Mixior/Projekt_Przejsciowy/linki.txt

https://www.tme.eu/pl/details/os5oka5111y/diody-led-tht-5mm/optosupply/
https://www.tme.eu/pl/details/luw503f43/diody-led-tht-5mm/wenrun/luw503f43-a-02/
https://www.tme.eu/pl/details/ltw30eedyja/diody-led-tht-5mm/liteon/
https://www.tme.eu/pl/details/pm2e-1lwe/diody-led-mocy-biale-emiter/prolight-opto/
