Mixior/Projekt_Przejsciowy/Materialy/Projekt oświetlenia w pojeździe - Nawrot, Smyczyński/Wykaz elementów.pdf

C26, C28 | 100n | C0603 | 18 | https://www.tme.eu/pl/details/cl10b104ko8nnnc/kondensatory-mlcc-smd-0603/samsung/
C4, C6, C25, C41, C44 | 10uF/50V | 153CLV-0605 | 5 | https://www.tme.eu/pl/details/tyeh1h106f55mtr/kondensatory-elektrolityczne-smd-105c/te-connectivity/
C7, C8, C27 | 3,3n | C0603 | 3 | https://www.tme.eu/pl/details/cc0603krx7r9332/kondensatory-mlcc-smd-0603/yageo/cc0603krx7r9bb332/
C10,C15,C29 | 390p | C0603 | 3 | https://www.tme.eu/pl/details/c0603c391j5gac/kondensatory-mlcc-smd-0603/kemet/c0603c391j5gactu/
C12,C18,C31 | 33pF | C0603 | 3 | https://www.tme.eu/pl/details/06035a330jat2a/kondensatory-mlcc-smd-0603/avx/
C13 | 330p | C0603 | 1 | https://www.tme.eu/pl/details/06031c331k4t2a/kondensatory-mlcc-smd-0603/avx/
C16,C20-C22,C30,C33,C34 | 47uF/50V | 153CLV-0605 | 7 | https://www.tme.eu/pl/details/sc1h476m6l07kvr/kondensatory-elektrolityczne-smd-85c/samwha/
C19,C32 | 470p | C0603 | 1 | https://www.tme.eu/pl/details/06035c471k4t2a/kondensatory-mlcc-smd-0603/avx/
C36, C37, C38 | 10uF/50V X | C1206 | 3 | https://www.tme.eu/pl/details/c1206c105k3rac/kondensatory-mlcc-smd-1206/kemet/c1206c105k3ractu/
D1-D4,D6 | SS15 | DO-214AC | 5 | https://www.tme.eu/pl/details/ss15-dc/diody-schottky-smd/dc-components/ss15/
D7 | 1N4148 | D0603 | 1 | https://www.tme.eu/pl/details/1n4148-
D5 | BAV70.215 | SOT23 | 1 | https://www.tme.eu/pl/details/bav70.215/diody-uniwersalne-smd/nexperia/
IC1 | MCP16301HT-E/CH | SOT23-6 | 1 | https://www.tme.eu/pl/details/mcp16301ht-e_ch/regulatory-napiecia-uklady-dcdc/microchip-technology/
JP1 | 1x5 | 1X05 | 1 | https://www.tme.eu/pl/details/zl201-05g/listwy-i-gniazda-kolkowe/connfly/ds1021-1_5sf1-1/
L1-L3 | 47uH/440mA | 0403 | 3 | https://www.tme.eu/pl/details/dlg-0403-470/dlawiki-smd-mocy/ferrocore/
L4 | 47uH/720mA | 0504 | 1 | https://www.tme.eu/pl/details/dlg-0504-470/dlawiki-smd-mocy/ferrocore/
L5 | WLPN303015M150PB | 3 x 3 x 1.5mm | 1 | https://www.tme.eu/pl/details/wlpn303015m150pb/dlawiki-smd-mocy/walsin/
LED1-LED6, LED9-LED14, LED16- | FYLS-5050N | 5050, PLCC6 | 36 | https://www.tme.eu/pl/details/fyls- (https://www.tme.eu/pl/details/fyls-5050nrgbc/diody-led-smd-kolorowe/foryard/)
LED7, LED8, LED15, LED22, LED29, LED42 | X42180 | lambertian | 6

https://www.tme.eu/pl/details/pm2b-1lwe/diody-led-mocy-biale-emiter/prolight-opto/https://www.tme.eu/pl/details/pm2b-1lre/diody-led-mocy-kolorowe-emiter/prolight-opt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
PH1 | PGM5537 | VT800 | 1 | https://www.tme.eu/pl/details/pgm5537/fotorezystory/token/
Q1-Q3 | BSS314 | SOT23 | 3 | https://www.tme.eu/pl/details/bss314peh6327xtsa1/tranzystory-z-kanalem-p-smd/infineon-technologies/
R1-R4,R15,R16,R27-R34 | 4k7 | R0603 | 14 | https://www.tme.eu/pl/details/0603saj0472t5e/rezystory-smd-0603/royal-ohm/
R5,R7,R17 | 20k 0.1% | R0603 | 3 | https://www.tme.eu/pl/details/ar0603-20k-0.1%25/rezystory-precyzyjne-smd-0603/viking/ar03btcx2002/
R6,R8,R14,R18,R23 | 68k | R0603 | 5 | https://www.tme.eu/pl/details/crcw06038k06fktabc/rezystory-smd-0603/vishay/
R9,R10,R20,R24,R26, R35 | 10k | R0603 | 6 | https://www.tme.eu/pl/details/ar0603-10k-0.1%25/rezystory-precyzyjne-smd-0603/viking/ar03btcx1002/
R11,R13,R22 | 1M | R0603 | 3 | https://www.tme.eu/pl/details/ar0603-1m-0.1%25/rezystory-precyzyjne-smd-0603/viking/ar03btcx1004/
R12 | 100k | R0603 | 1 | https://www.tme.eu/pl/details/smd0603-100k/rezystory-smd-0603/royal-ohm/0603saj0104t5e/
Oznaczenie | Wartość | Obudowa | Szt. (dla jednej lampy) | link

C1-C3, C5, C23, C24, C35, C39, C40,C42, C43, C9, C11, C14, C17,

R19 | 0,56R 1% | R0603
R21 | 3k3 | R0603
R25 | 0R | R0603
R36 | 30k9 | R0603 | 1 | https://www.tme.eu/pl/details/rc0603f (https://www.tme.eu/pl/details/rc0603fr-0730k9l/rezystory-smd-0603/yageo/)
U1-U3 | ISL97671A | QFN20
U4 | AP8801 | SOP-08
U5 | STM32F042F | TSSOP20
U6 | PCA9545A | SO20W
U7 | SN65HVD230/1 | SO8
X1 | ARK R=5 | AK500/4
1 | https://www.tme.eu/pl/details/cs0603-0r56-1%25-hp/rezystory-smd-0603/viking/cs03ftfpr560/
1 | https://www.tme.eu/pl/details/smd0603-3k3/rezystory-smd-0603/royal-ohm/0603saj0332t5e/
1 | https://www.tme.eu/pl/details/smd0603-0r/rezystory-smd-0603/royal-ohm/0603saj0000t5e/
3 | http://pl.farnell.com/intersil/isl97671airz/led-driver-boost-6-channel-qfn/dp/2687076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
1 | http://pl.farnell.com/diodes-inc/ap8801sg-13/ic-led-driver-buck-0-5a-8sop/dp/1825358RL
1 | https://www.tme.eu/pl/details/stm32f042f6p6/mikrokontrolery-st/st-microelectronics/
1 | https://www.tme.eu/pl/details/pca9545ad/uklady-scalone-interfejs-i2c/nxp/pca9545ad112/
1 | https://www.tme.eu/pl/details/sn65hvd230d/uklady-scalone-interfejs-can/texas-instruments/
1 | https://www.tme.eu/pl/details/dg300-5.0-04p13/listwy-zaciskowe-do-druku/degson-electronics/dg300-50-04p-13-00ah/
