Mixior/Projekt_Przejsciowy/Materialy/eRower_Lights/PROJEKT/Raport.pdf

## Oświetlenie pojazdu elektrycznego przy użyciu magistrali CAN

Sergiusz Grześkowiak
Michał Kowalewski
Łukasz Jaskulski

2018

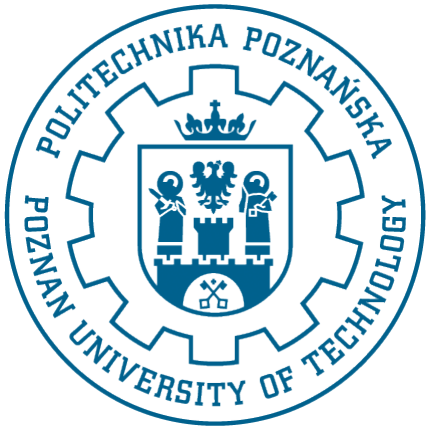
[picture p9: figure]

Stworzono przy użyciu LATEX

## Spis treści

1 Założenia i schematy | 2
2 Oprogramowanie | 8

1

## 1 Założenia i schematy

### 1.1 Kierunkowskazy

Projektując kierunkowskazy do pojazdu elektrycznego wzorowaliśmy się na dizajnie marki Audi. Gdzie w nowych modelach stosowane są dynamicznie płynące światła, jest to według nas najciekawsze rozwiązanie stawiające przed nami nowe wyzwania i możliwości. Problemem w sterowaniu tymi światłami jest to że każda pojedyncza dioda każdego kierunkowskazu musi posiadać osobne sterowanie barwą i natężeniem światła (w celu uzyskania płynnego efektu migania kierunkowskazu), ponad to światła te muszą spełniać rolę świateł do jazdy dziennej. Problemy te rozwiązaliśmy stosując paski ledowe oparte na diodach WS2811, które to diody zawierają wbudowany prosty układ scalony który umożliwia sterowanie wszystkimi diodami za pomocą jednego wyjścia mikrokontrolera.

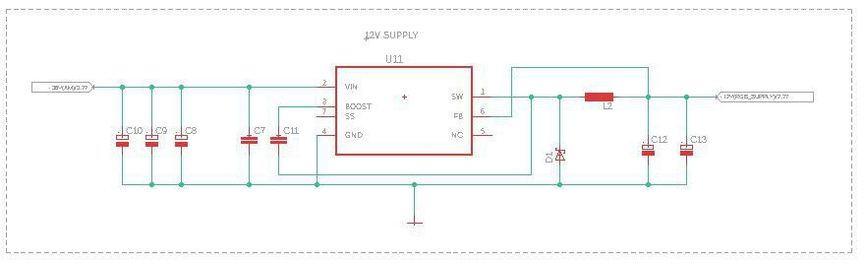
[picture p10: figure]

Rysunek 1: Zasilanie +12V DC programowalnych diod rgb

### 1.2 Światła mijania, drogowe, stopu

Do sterowania diodami dużej mocy zastosowaliśmy układ AP8801 500mA LED STEP-DOWN CONVERTER oprócz wspólnego sterowania dla każdego typu świateł każdy zestaw świateł zawierać będzie zestaw 2 pasków led (pojedynczy pasek na lewą i prawą stronę) po 9 diod, na każdy jeden pasek przypadać będzie jeden układ AP8801 (ze względu na jego wewnętrzne ograniczenia). W sumie samych układów step down będzie 6 każdy będzie odpowiedzialny za jedno światło(mijania lewe, mijania prawe, drogowe lewe, drogowe prawe, stop/mijania tylne lewy, stop/mijania tylne prawy), umożliwi to proste sterowanie i wykrywanie awarii oświetlenia.

2

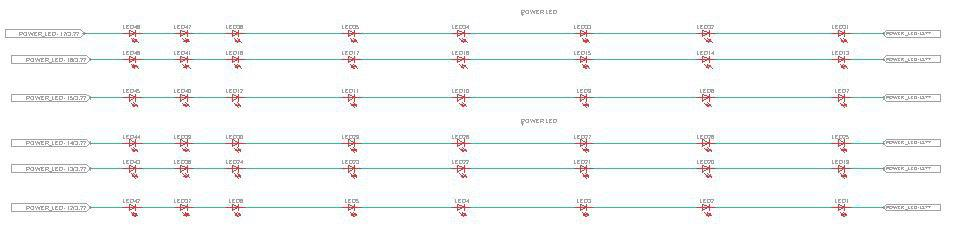
[picture p11: figure]

Rysunek 2: Paski 9 diod świateł mijania/drogowych/stop

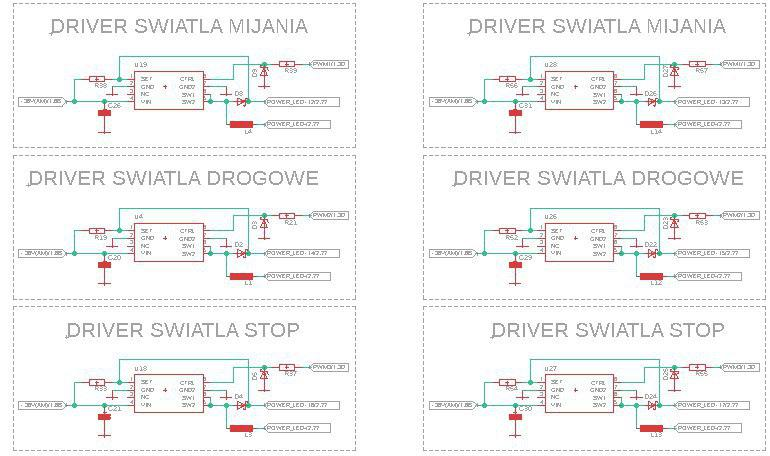
[picture p12: figure]

Rysunek 3: Podział Power LED draiverów na poszczególne segmenty

Awarie świateł wykrywamy aktywnie przy uruchomieniu pojazdu mierzony jest wówczas prąd pobierany na cały układ i porównywany z wartością znamionową. Ze względu na użycie jednego układu AP8801 na jedno światło w momencie przepalenia jednej diody prąd pobierany spadnie o jedną szóstą.

3

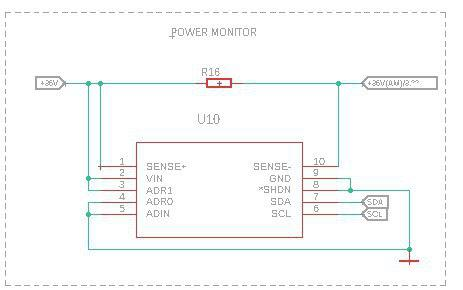
[picture p13: figure]

Rysunek 4: Wysoko napięciowy monitor prądu i napięcia z magiistralą I2C

### 1.3 Zasilanie

Zgodnie z założeniami cały projekt działa na zasilaniu +36 V DC. Ze względu na wykorzystanie mikrokontrolera STM 32, oraz programowalnych diod led, stosujemy 2 układy obniżania napięcia z 36V na 3,3V (do mikrokontrolera) oraz 12V (do programowalnych diod).

4

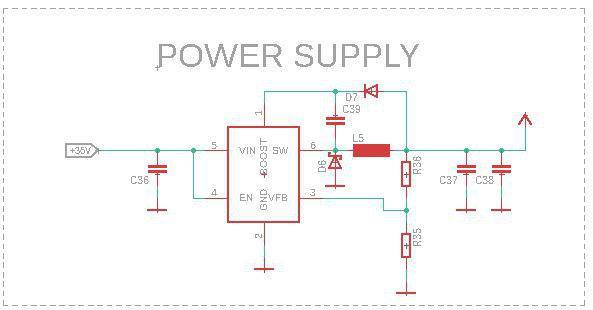
[picture p14: figure]

Rysunek 5: Stepdown na 3V3 dla mikrokontrolera

### 1.4 BRD

Schemat brd został zaprojektowany zachowując odpowiednie szerokości ścieżek proporcjonalnie do płynących w nich sygnałów. Kondensatory odsprzęgające znajdują się możliwie najbliżej układów scalonych. Uniknięto zamknięcia pętli masy.

Poprzez duże nagromadzenie elementów na jednej płytce. Możliwie redukujemy koszty wykonania gotowych modułów . Ograniczamy zbędne miejsce, które pojawiłoby się w przypadku rozdzielenia modułów. Ponadto zwężamy koszt o zamówienie tylko jednego projektu, co przekłada się na lepsze warunki podczas masowej produkcji.

5

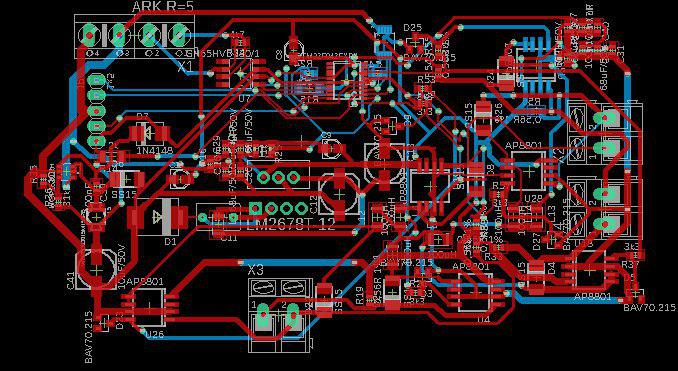
[picture p15: figure]

Rysunek 6: Kolorem czerwonym zaznaczone są ścieżki warstwy górnej, natomiast niebieskim warstwy dolnej

### 1.5 Mikrokontroler

Zastosowanym mikrokontrolerem jest STM32F042F6P6. Zgodnie z założeniami projektu wybraliśmy mikrokontroler z rodziny STM32. Jest to najtańszy mikrokontroler z rodziny STM32 obsługując magristralę CAN, a jednocześnie w zupełności zaspokajający potrzeby projektu.

6

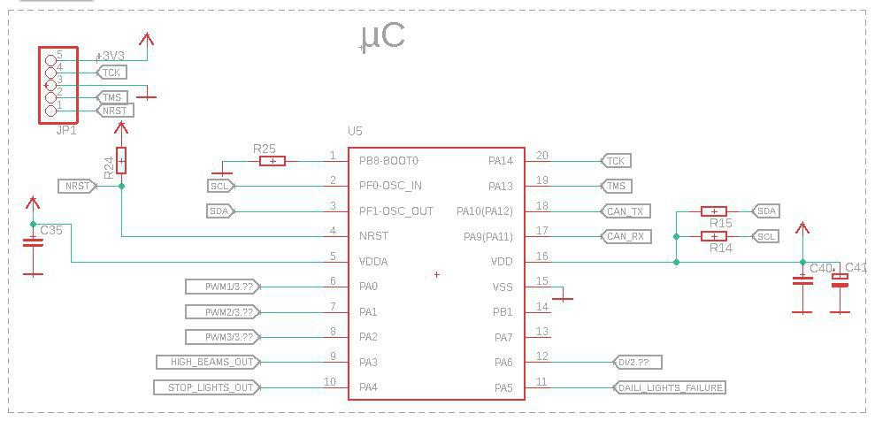
[picture p16: figure]

Rysunek 7: Schemat STM32F042F6P6

7

## 2 Oprogramowanie

### 2.1 Konfiguracja wyprowadzeń mikrokontrolera

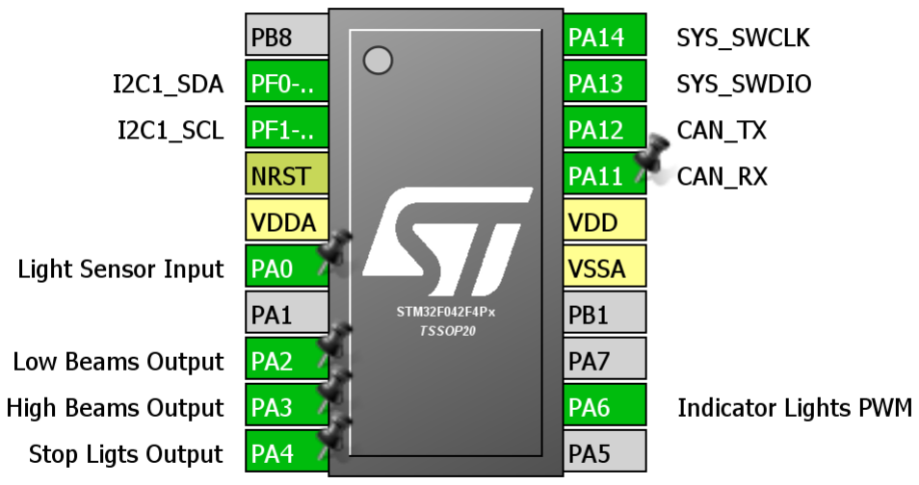
[picture p17: figure]

Rysunek 8: Wyprowadzenia mikrokontrolera

Zastosowanie innych rozwiązań niż poprzedni twórcy projektu [1] pozwoliło na wykorzystanie mniejszej ilości wyprowadzeń mikrokontrolera. W połączeniu z konfiguracją Debug Serial Wire na pinach PA14 oraz PA13 mamy możliwość przeprogramowania mikrokontrolera w przyszłości, co może pozwolić na dodanie dodatkowych funkcji i wykorzystanie niezagospodarowanych wyprowadzeń.

8

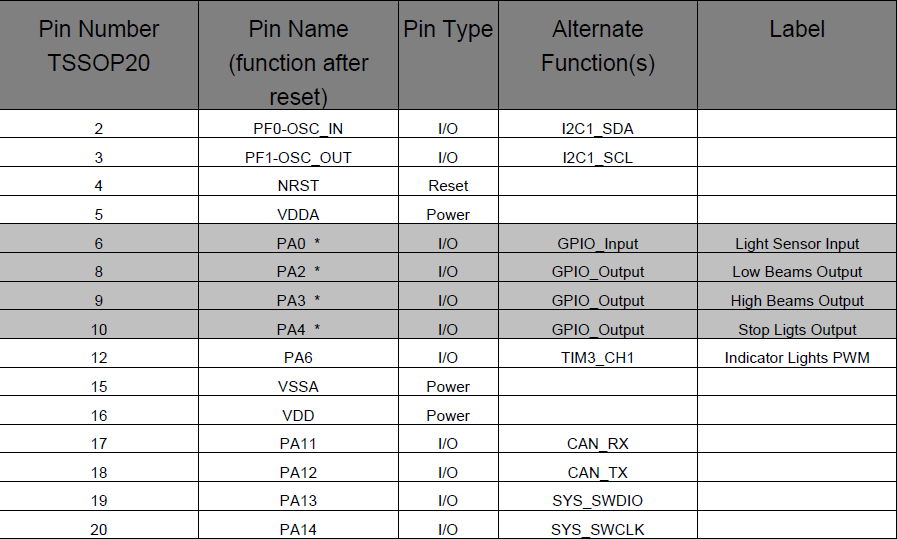
[picture p18: figure]

Rysunek 9: Raport konfiguracja wyprowadzeń

### 2.1.1 I2C

Wyprowadzenia PF0-OSC_IN oraz PF1-OSC_OUT zostały wykorzystane do skonfigurowania magistrali I

2C. Mikrokontroler komunikuje się tą magistralą z monitorem prądu LTC4151, który służy do wykrywania awarii układu [3].

9

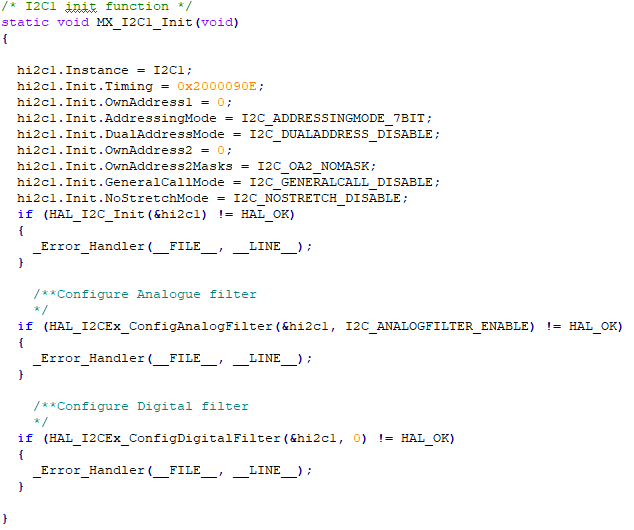
[picture p19: figure]

Rysunek 10: Inicjalizacja komunikacji po magistrali I

2C rzy użyciu HAL

Konfiguracja I

2C uniemożliwiła wykorzystanie zewnętrznego oscylatora kwarcowego [2], przez co do taktowania procesora wykorzystujemy wbudowany oscylator 48MHz, który dla naszych zastosowań jest bardziej niż wystarczający.

### 2.1.2 Piny wejścia/wyjścia

Do sterowania oświetlenie wykorzystane są wyprowadzenia PA2, PA3, PA4 oraz PA6. Pin PA0 służy do monitorowania stanu czujnika światła.

10

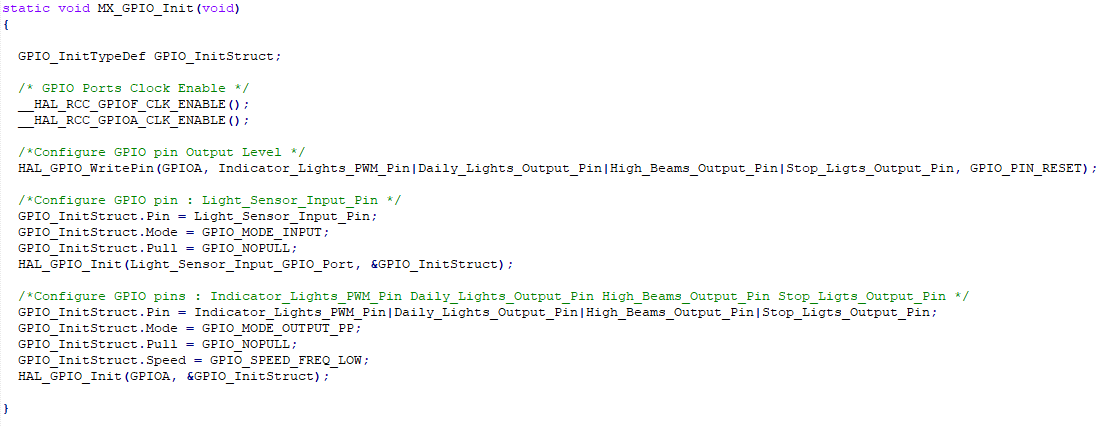
[picture p20: figure]

Rysunek 11: Konfiguracja pinów wejścia/wyjścia

### 2.1.3 CAN

Zgodnie z wymaganiami specyfikacji [2], do komunikacji po magistrali CAN wykorzystane zostały wyprowadzenia PA11 oraz PA12. Szczegóły konfiguracji zostaną opisane w dalszej części raportu.

11

### 2.2 Timery

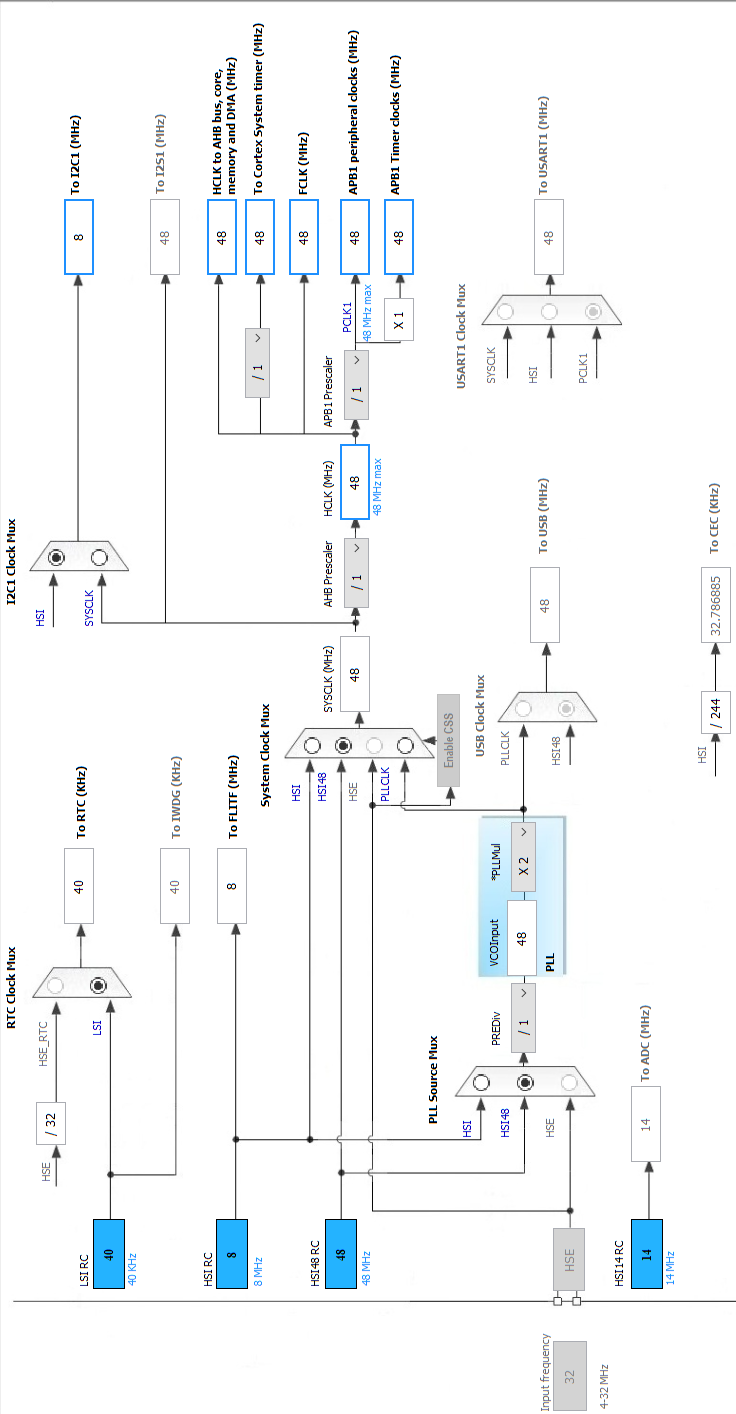
[picture p21: figure]

Rysunek 12: Konfiguracja zegarów mikroprocesora w IDE STM32CubeMX

12

W projekcie wykorzystywane są trzy wewnętrzne oscylatory:

- HSI RC, służy do taktowania magistrali I

2C z częśtotliwością 8MHz

- HSI48 RC, taktuje procesor z częstotliwością 48MHz
- LSI RC wykorzystujemy do konfiguracji zegara czasu rzeczywistego.

Ponadto w projektcie używane są dwa liczniki: Timer3 oraz RTC. Timer3 służy do generowania sygnału PWM sterującego programowalną listwe LED. Wszystkie zegary, oprócz zegara RTC zostały skonfigurowane z pomocą powłoki HAL.

13

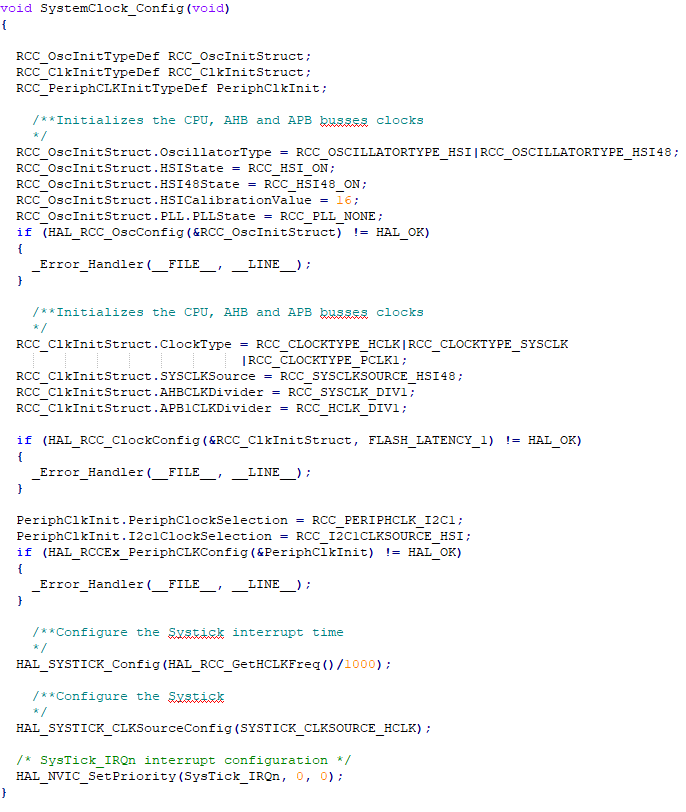
[picture p22: figure]

Rysunek 13: Funkcja konfigurująca główne zegary procesora

### 2.2.1 Real Time Clock

Do obsługi kierunkowskazów oraz świateł awaryjnych konieczne było skonfigurowanie zegara czasu rzeczywistego (RTC). Wykorzystuje on wewnętrzny

14 oscylator niskoczęstotliowściowy (LSI RC) o częstotliwości 40kHz. Odczytywanie czasu rzeczywistego od uruchomienia modułu zostało zaprogramowane w funkcji void RTC (*p_buf). Przez wywołanie odpowiedniej funkcji jesteśmy wstanie odczytać czas od uruchomienia w postaci godzin, minut, sekund i milisekund.

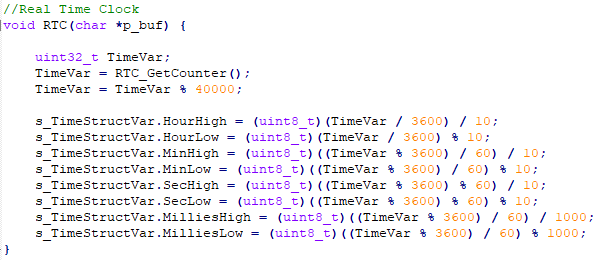
[picture p23: figure]

Rysunek 14: Funkcja konfigurująca zegar czasu rzeczywistego

W momencie włączenia kierunkowskazu lub świateł awaryjnych generowany jest sygnał PWM włączający odpowiednie diody oraz zapisywana jest do zmiennej wartość z zegara czasu rzeczywistego. Przy następnym cyklu procesora zapisana wartość porównywana jest z nową wartością RTC i następuje sprawdzenie, czy różnica czasu jest większa lub równa wartości stałej Indicator_interval.

Stała Indicator_Interval została zadekalrowana jako const static unsigned int, w celu obptymalizacji zużycia pamięci mikroprocesora, a jego wartość ustaliliśmy jako 500.

15

Oznacza to, że po upływie 500 milisekund następuje sekwencja włączania lub wyłączania odpowiednich diod. Daje nam to pulsacje o okresie 1 sekundy.

### 2.3 CAN

Podstawowym zadaniem przy pisaniu opragramowania było konfiguracja komunikacje po magistrali CAN. Pin PA12 służy do wysyłania informacji po magistrali, natomiast PA13 do odbierania.

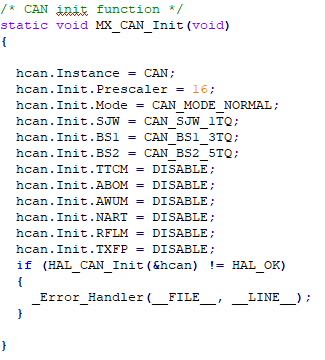
[picture p24: figure]

Rysunek 15: Inicjalizacja CAN

Zgodnie z dokumentacją [2], skonfigurowane zostały trzy skrzynki odbiorcze, w których przechowywane są wiadomości, aż do czasu wykonania odpowiednich funkcji.

16

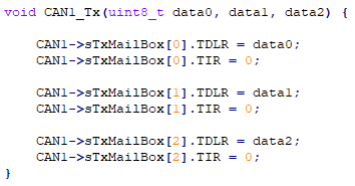
[picture p25: figure]

Filtr magistrali został skonfigurowany na priorytet identyfikatora wiadomości. Oznacza to, że informacja z niższym numerem ID zostanie obsłużona jako pierwsza.

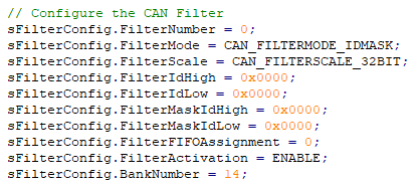
[picture p26: figure]

W projekcie założyliśmy siedem modułów, od których może zostać odebrany sygnał: Przełącznik świateł długich, świateł drogowych, świateł awaryjnych, pedał stopu oraz obu kierunkowskazów.

17

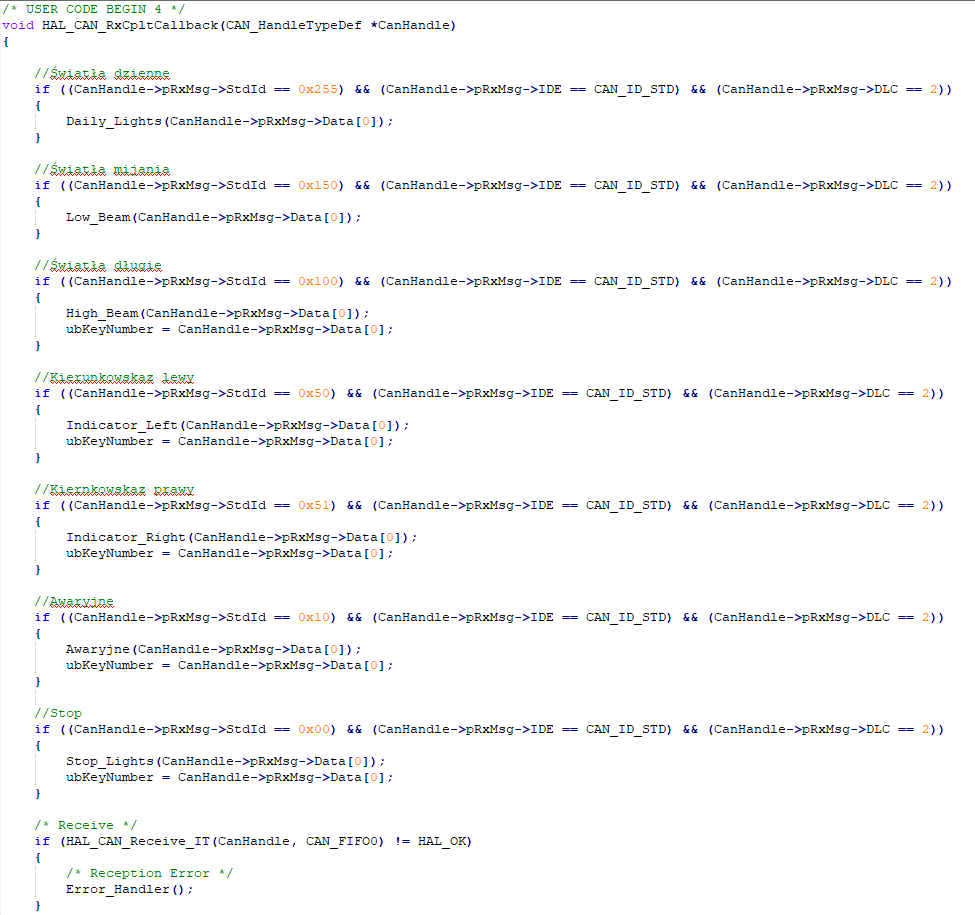
[picture p27: figure]

Rysunek 16: Obsługa odbioru wiadomości od poszczególnych modułów

Przyjęliśmy, że najniższe ID (0x00) będzie posiadał komunikat o światłach stopu. Oznacza to, że informacja o wciśnięciu lub zwolnieniu hamulca będzie zawsze obsługiwana jako pierwsza. Następnie w kolejności: informacja o światłach arawyjnych, kierunkowskazach, światłach długich, światłach mijania oraz światłach dziennych.

Jednakże z powodu, że instrukcje procesora są proste i jedynie programowalna listwa RGB wymaga od nas modulacji bardziej skomplikowanego sygnału PWM, nie spodziewamy się sytuacji przepełnienia skrzynki odbiorczej. Nawet sytuacja w której otrzymalibyśmy trzy informacje na raz nie powinna

18 wywołać widocznego opóźnienia reakcji.

### 2.4 Programowalna listwa LED

Wykorzystanie diod programowalnych typu WS2811 pozwoliło wyeliminować LED drivery zastosowane przez poprzednią grupę, oraz sterowanie czterena kierunkowskazami oraz światłami dziennymi jednym sygnałem PWM.

Sygnał dla WS2811 nie jest sygnałem typowym. Wartość niska kodowana jest przez ustawienie stanu wysokiego przez 220ns do 380ns [4], a następnie stanu niskiego trwającego od 580ns do 1,6us. Natomiast stan wysoki kodujemy ustawiając stan wysoki na 580ns do 1,6us, a następnie stan niski od 220ns do 420ns. Ustawienie stanu niskiego przez minimum 280us stanu niskiego oznacza reset.

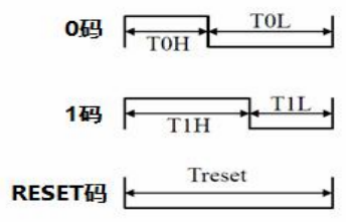
[picture p28: figure]

Rysunek 17: Kodowanie bitu [4]

Pojedyncze słowo składa się 24 bitów. W słowie przypada 8 bitów na pojedynczą diodę: Czerwoną, Niebieską i zieloną. 8 bitów pozwala nam uzyskać 255 stopni regulacji intensywności świecenia dla każdej z 3 składowych diod.

19

Rysunek 18: Kompozycja jednego słowa [4]

Sterowniki diod połączone są ze sobą kaskadowo. Każdy sterownik interpretuje najmłodsze słowo sygnału, odcine je i przekazuje resztę sygnału dalej, tak jak pokazano to na rysunkach.

Rysunek 19: Kaskadowe połączenie sterowników [4]

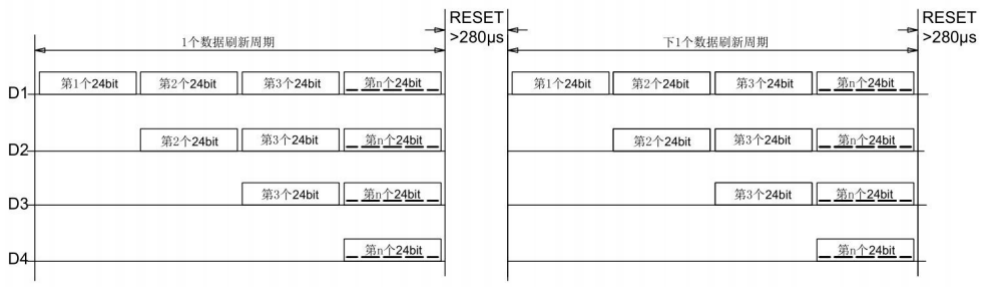
[picture p29: figure]

Rysunek 20: Zasada przepływu sygnałów [4]

Oznacza to, że w pojedynczej sekwencji musimy nadać 180 bajtów. Licząc, że na nadanie jednego bitu potrzeba około 1us, to pojedyncza sekwencja będzie trwać 1440us + 280us bitu stopu. Rozważmy przypadek w którym obsługujemy kierunkowskaz i rozpoczynamy wysyłanie 60 słów do naszego paska ledowego. Jeśli w tym samym momencie użytkownik wyłączy kierunkowskaz, to dla ludzkiego oka reakcja będzie natychmiasotwa, mimo

20 konieczności nadania wszystkich słów.

Tak jak było wspomniane, sygnał modulowany dla listwy ledowej jest dość nietypowy, przez co obsługa jje mogłaby przysporzyć wielu problemów. Na szczęście w powłoce HAL dostępna jest biblioteka znacznie ułatwiająca konfiguracje.

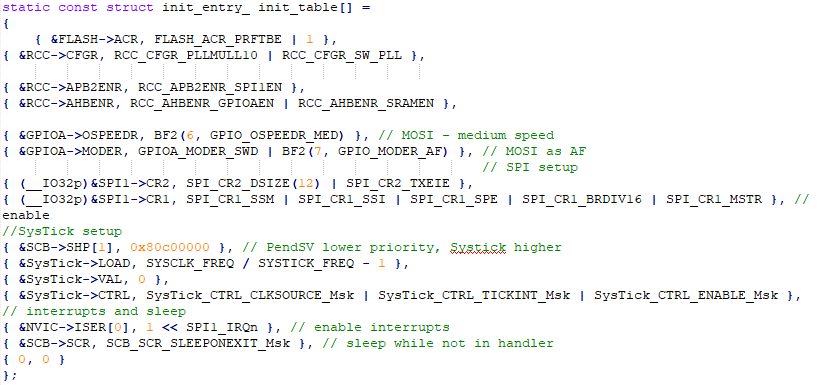
[picture p30: figure]

Dzięki temu byliśmy wstanie zaprogramować płynnięcie kierunkowskazu, wzrosując się na efekcie uzyskanym w samochodach marki Audi.

21

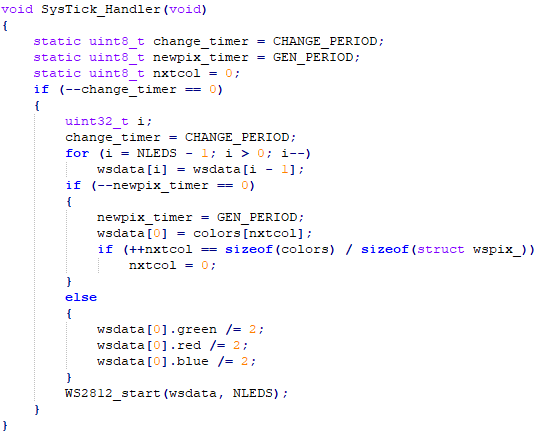
[picture p31: figure]

### 2.5 Czujnik światła

Po uruchomieniu pojazdu, w zależności od sygnału z czujnika natężenia światła następuje włączenie świateł dziennych lub mijania. Oświetlenie jest przełączane w zależności od obecnych odczytów czujnika do czasu aż operator pojazdu nie wykona następujących operacji: Ręczne wyłączenie świateł dziennych lub mijania, ręczne włączenie świateł długich, dziennych lub mijania. Po wystąpieniu takiego zdarzenia kontroler nie będzie reagował na sygnały z czujnika natężenia światła, aż do następnego uruchomienia pojazdu.

22

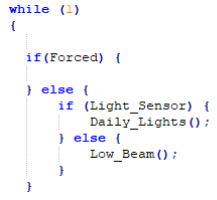
[picture p32: figure]

### 2.6 Wykrywanie awarii

Wykrywanie awarii polega na włączeniu na dwie sekundy wszystkich świateł i pomiar łącznego poboru prądu przez monitor prądu LTC4151. Wartość ta zostaje wysłana magistralą I

2C do mikrokontrolera, gdzie zostaje porównana ze znamionowym poborem prądu. Jeśli wartości różnią się od siebie o 20%, mikrokontroler wysyła po magistrali CAN (w domyśle do głównego komputera pojazdu) informacje o błędzie.

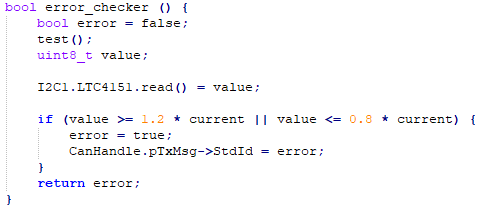
[picture p33: figure]

23

## Bibliografia

[1] Sławomir Smyczyński Arkadiusz Nawrot. Projekt oświetlenia w pojeździe. 2018.
[2] STM32. STM32F042x4 STM32F042x6 Data Sheet.
[3] Linear Technology. LTC4151 datasheet.
[4] Worldsemi. WS2811 - Signal line 256 Gray level 3 channel Constant current LED driver IC datasheet.

24
