Mixior/Projekt_Przejsciowy/Materialy/eRower_Lights/components.odt

OF-LM002-3B580 (http://www.tme.eu/pl/details/of-lm002-3b580/diody-led-mocy-biale-cob/optoflash/)
