Mixior/Projekt_Przejsciowy/Materialy/Projekt oświetlenia w pojeździe - Nawrot, Smyczyński/schemat_ideowy.pdf

# św. dzienne/kierunkowskaz

kolumna 6 | kolumna 5 | kolumna 4 | kolumna 3 | kolumna 2 | kolumna 1

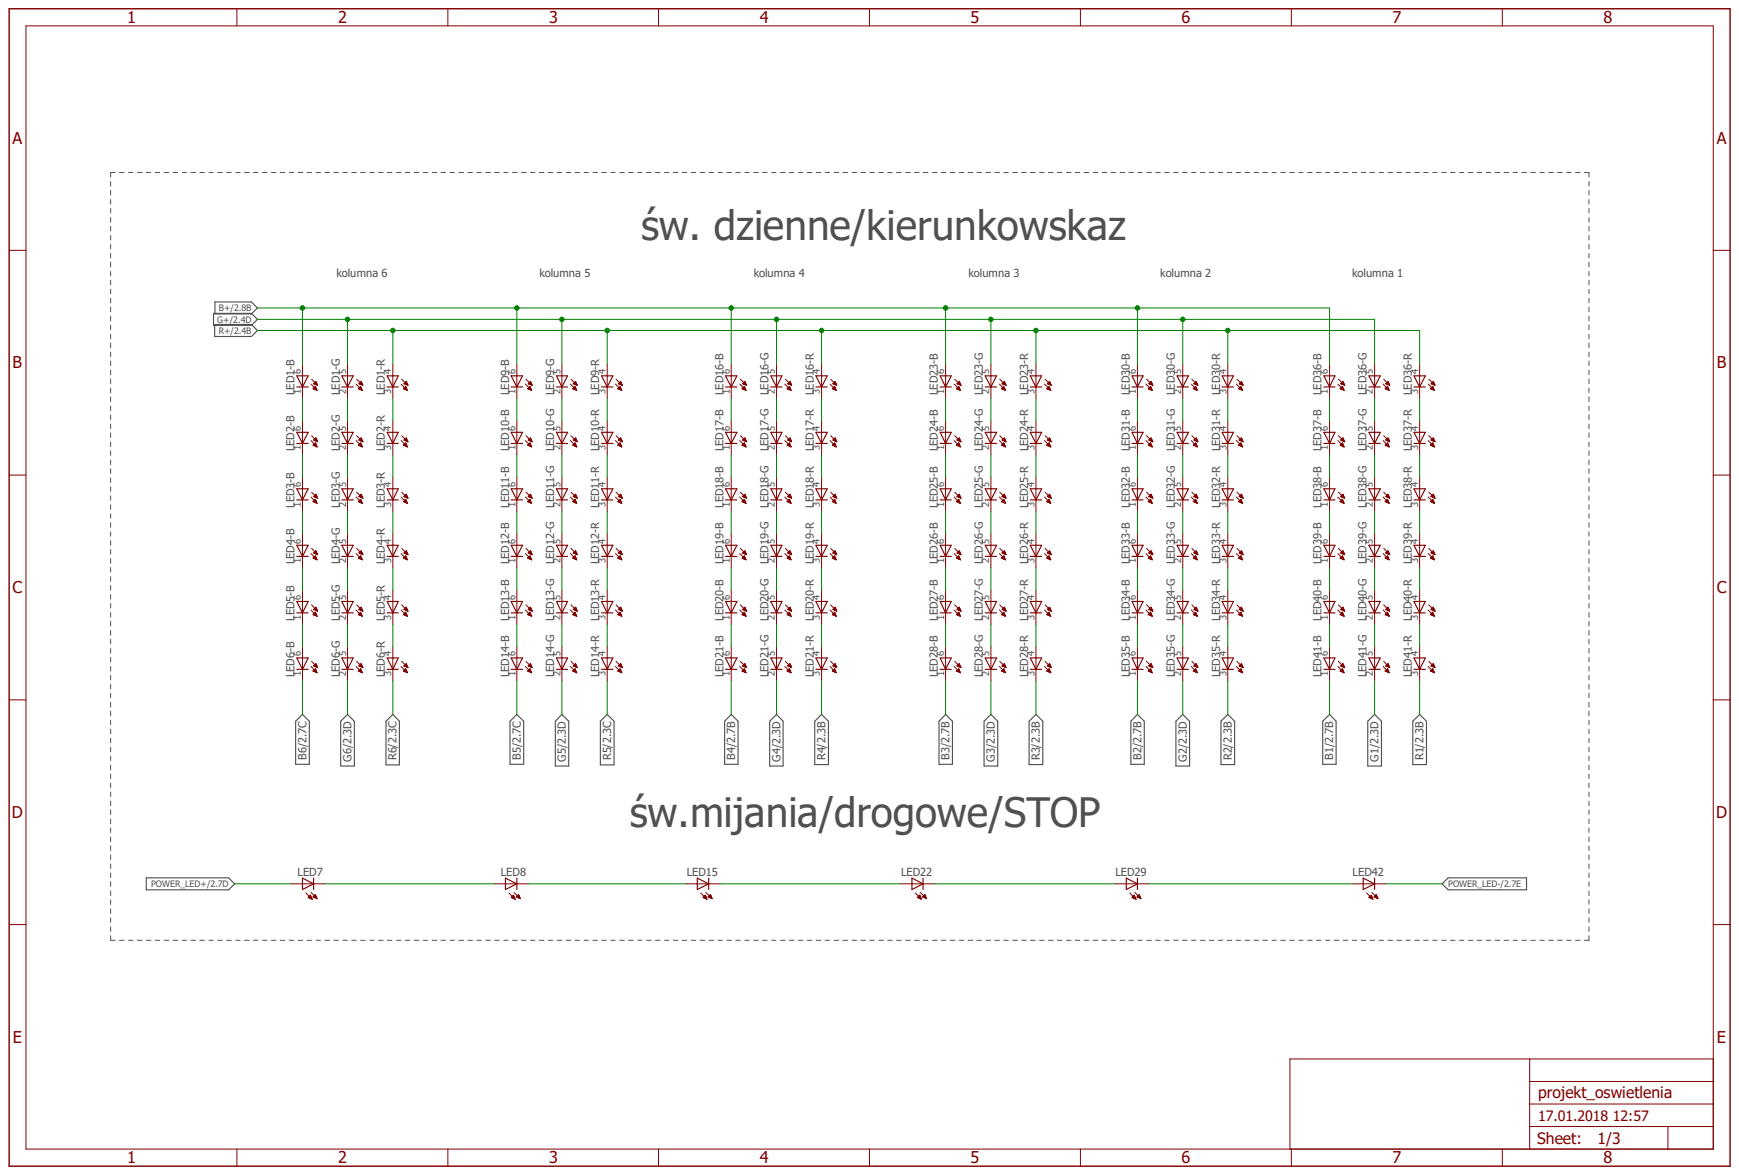
[picture p34: page 1]
św.mijania/drogowe/STOP LED⁹⁻B 1 6; LED⁹⁻G 2 5; LED⁹⁻R 3 4 LED¹⁰⁻B 1 6; LED¹⁰⁻G 2 5; LED¹⁰⁻R 3 4 LED¹¹⁻B 1 6; LED¹¹⁻G 2 5; LED¹¹⁻R 3 4 LED¹²⁻B 1 6; LED¹²⁻G 2 5; LED¹²⁻R 3 4 LED¹³⁻B 1 6; LED¹³⁻G 2 5; LED¹³⁻R 3 4 LED¹⁴⁻B 1 6; LED¹⁴⁻G 2 5; LED¹⁴⁻R 3 4 LED¹⁻B 1 6; LED¹⁻G 2 5; LED¹⁻R 3 4 LED²⁻B 1 6; LED²⁻G 2 5; LED²⁻R 3 4 LED³⁻B 1 6; LED³⁻G 2 5; LED³⁻R 3 4 LED⁴⁻B 1 6; LED⁴⁻G 2 5; LED⁴⁻R 3 4 LED⁵⁻B 1 6; LED⁵⁻G 2 5; LED⁵⁻R 3 4 LED⁶⁻B 1 6; LED⁶⁻G 2 5; LED⁶⁻R 3 4; LED²³⁻B 1 6; LED²³⁻G 2 5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

# LED DRIVER 3

# LED DRIVER 1 Q²

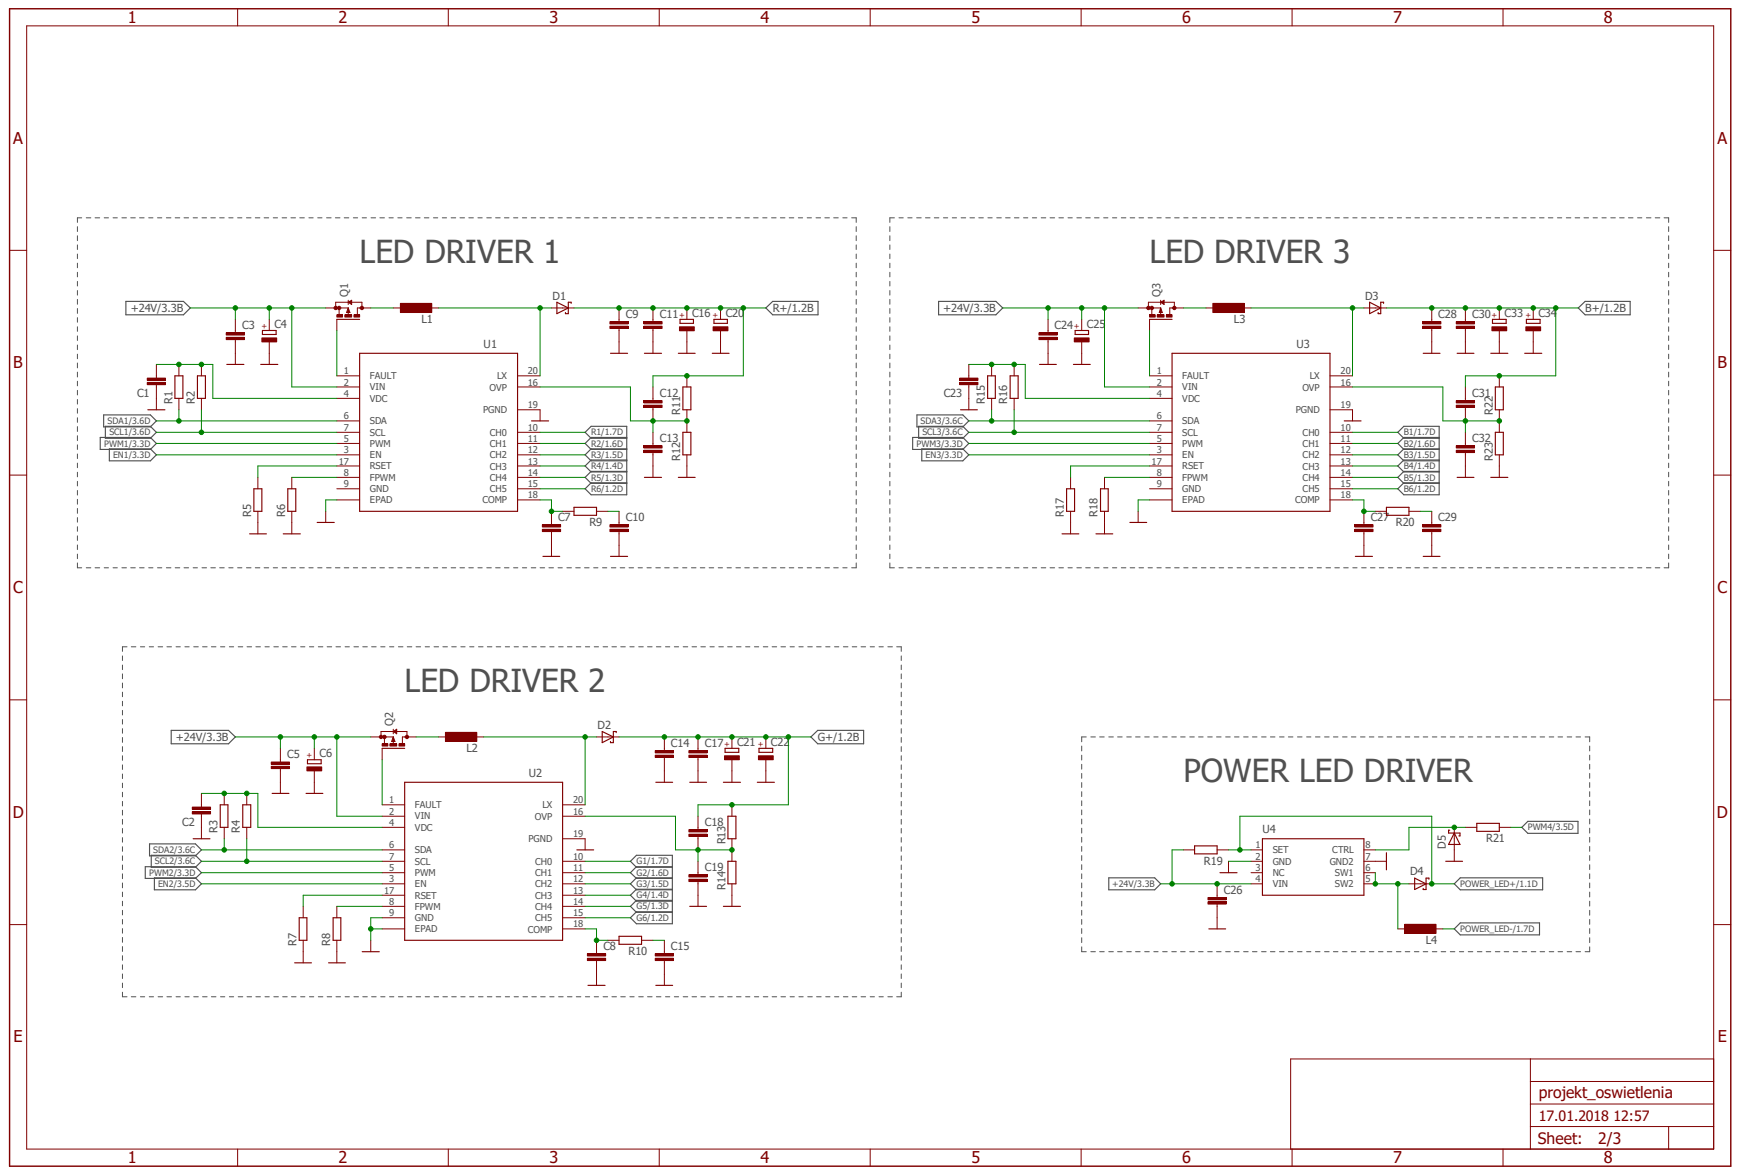
[picture p35: page 2]

# ZASILANIE

C39

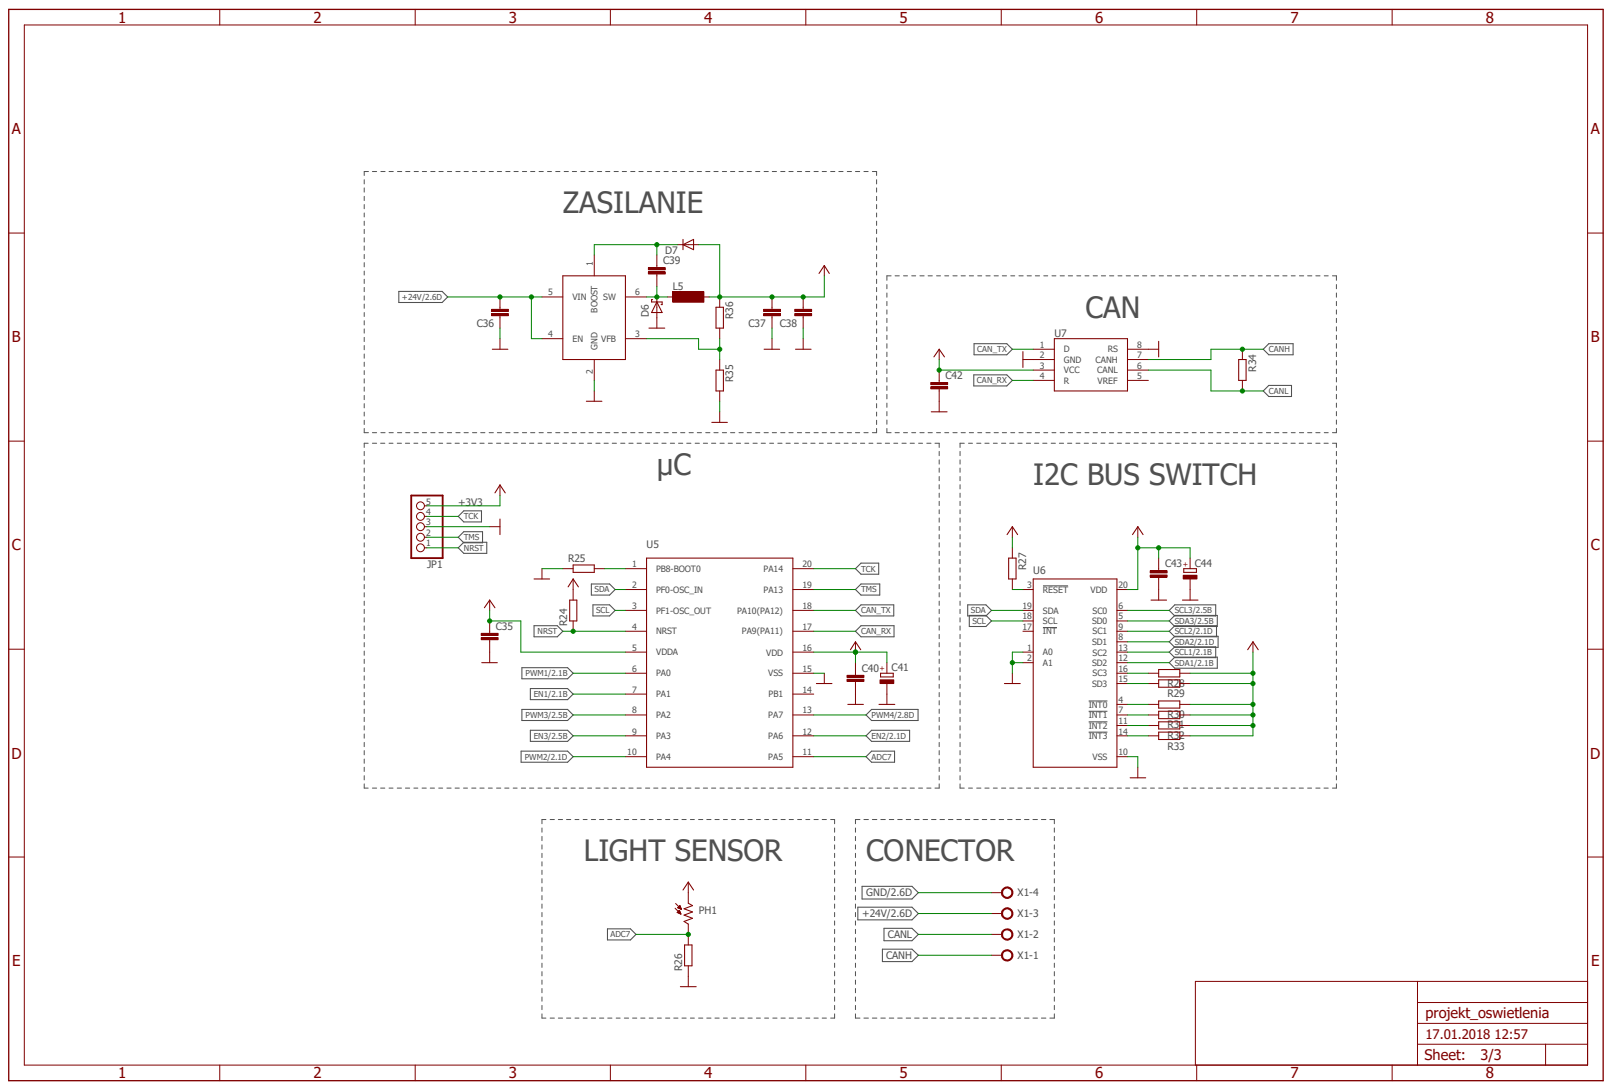
[picture p36: page 3]

4 CAN_RX I2C BUS SWITCH

NRST | VDDA 5 | CAN_RX
