Mixior/Projekt_Przejsciowy/Materialy/eRower_Lights/PROJEKT/projekt_oswietlenia1.pdf

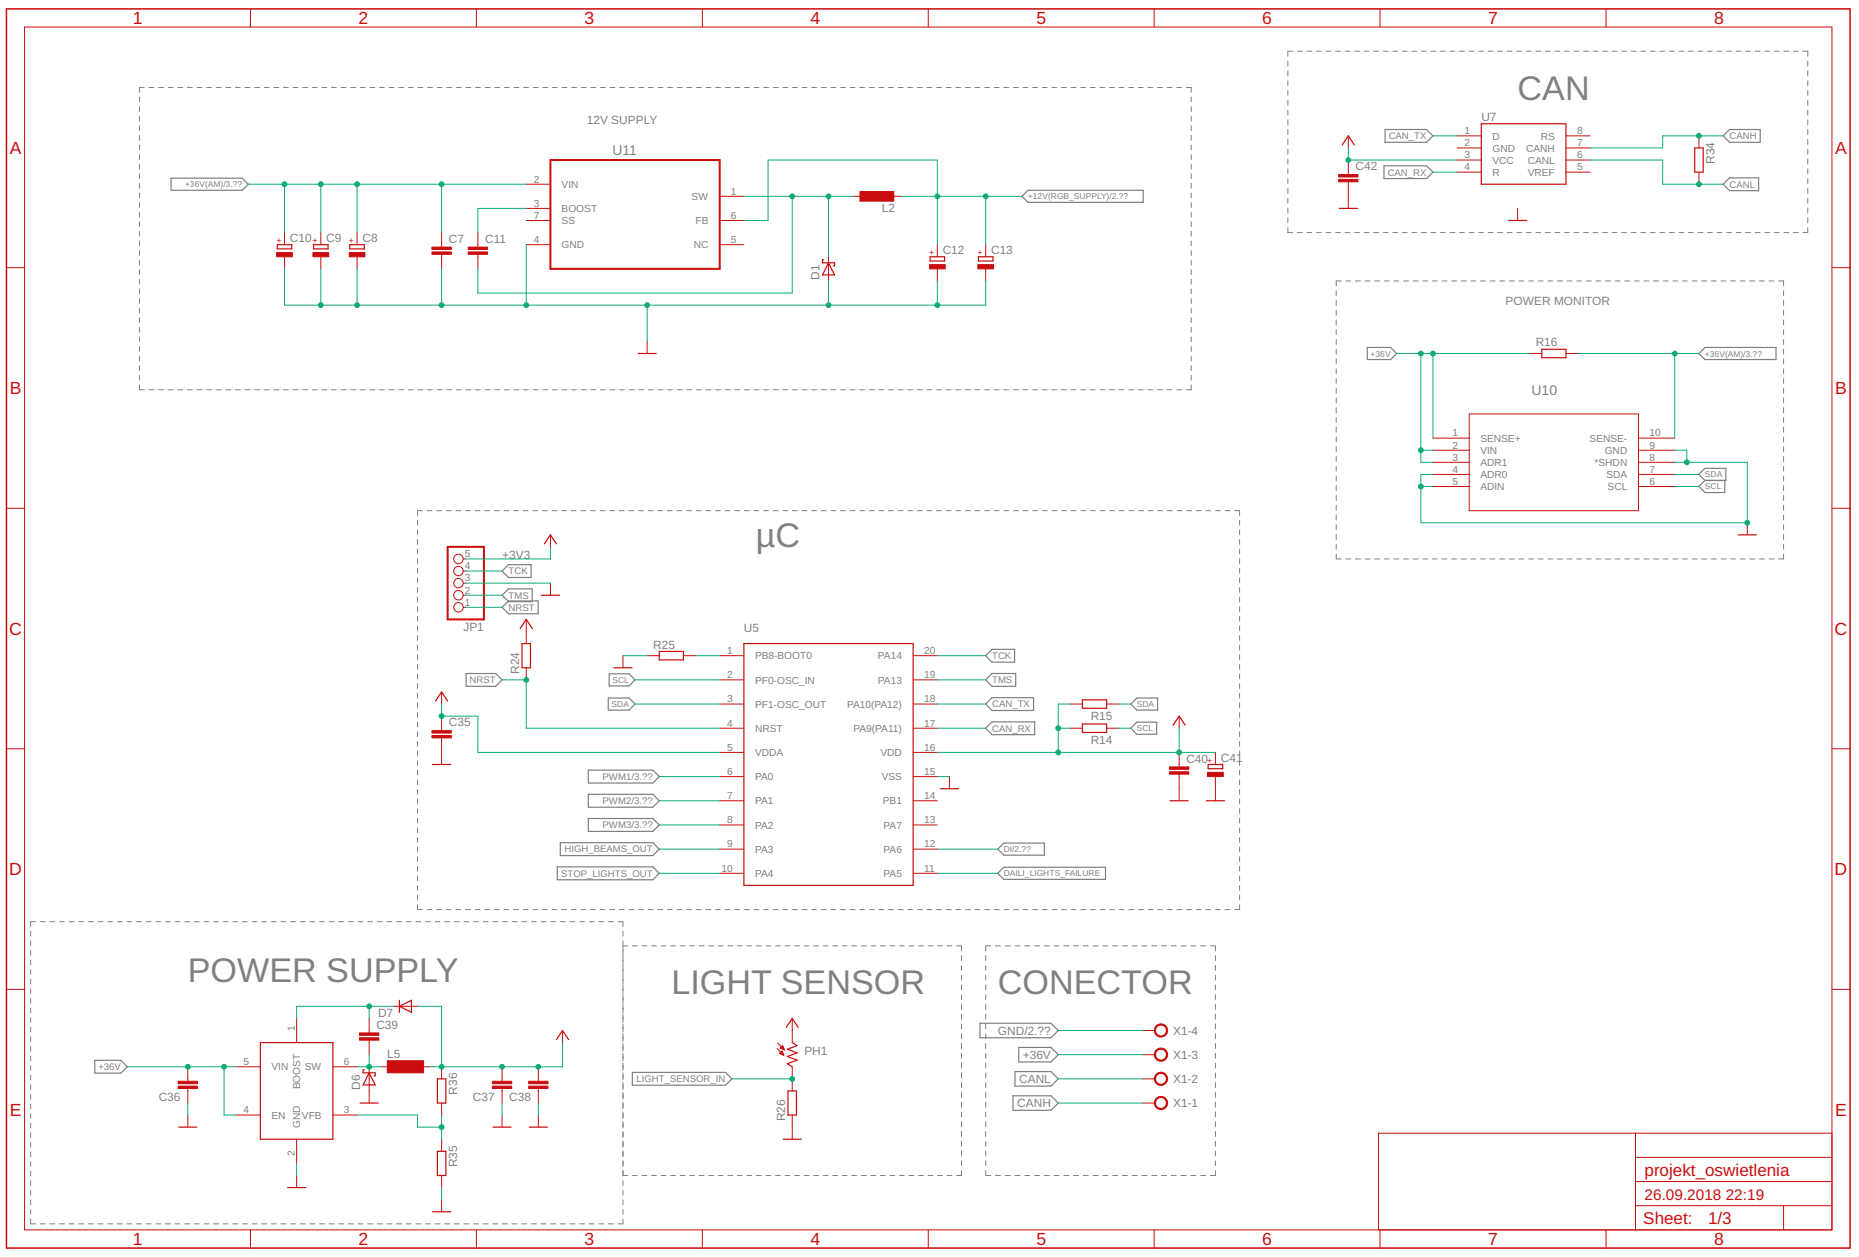
[picture p37: page 1]
