Mixior/Projekt_Przejsciowy/Materialy/eRower_Lights/PROJEKT/projekt_oswietlenia2.pdf

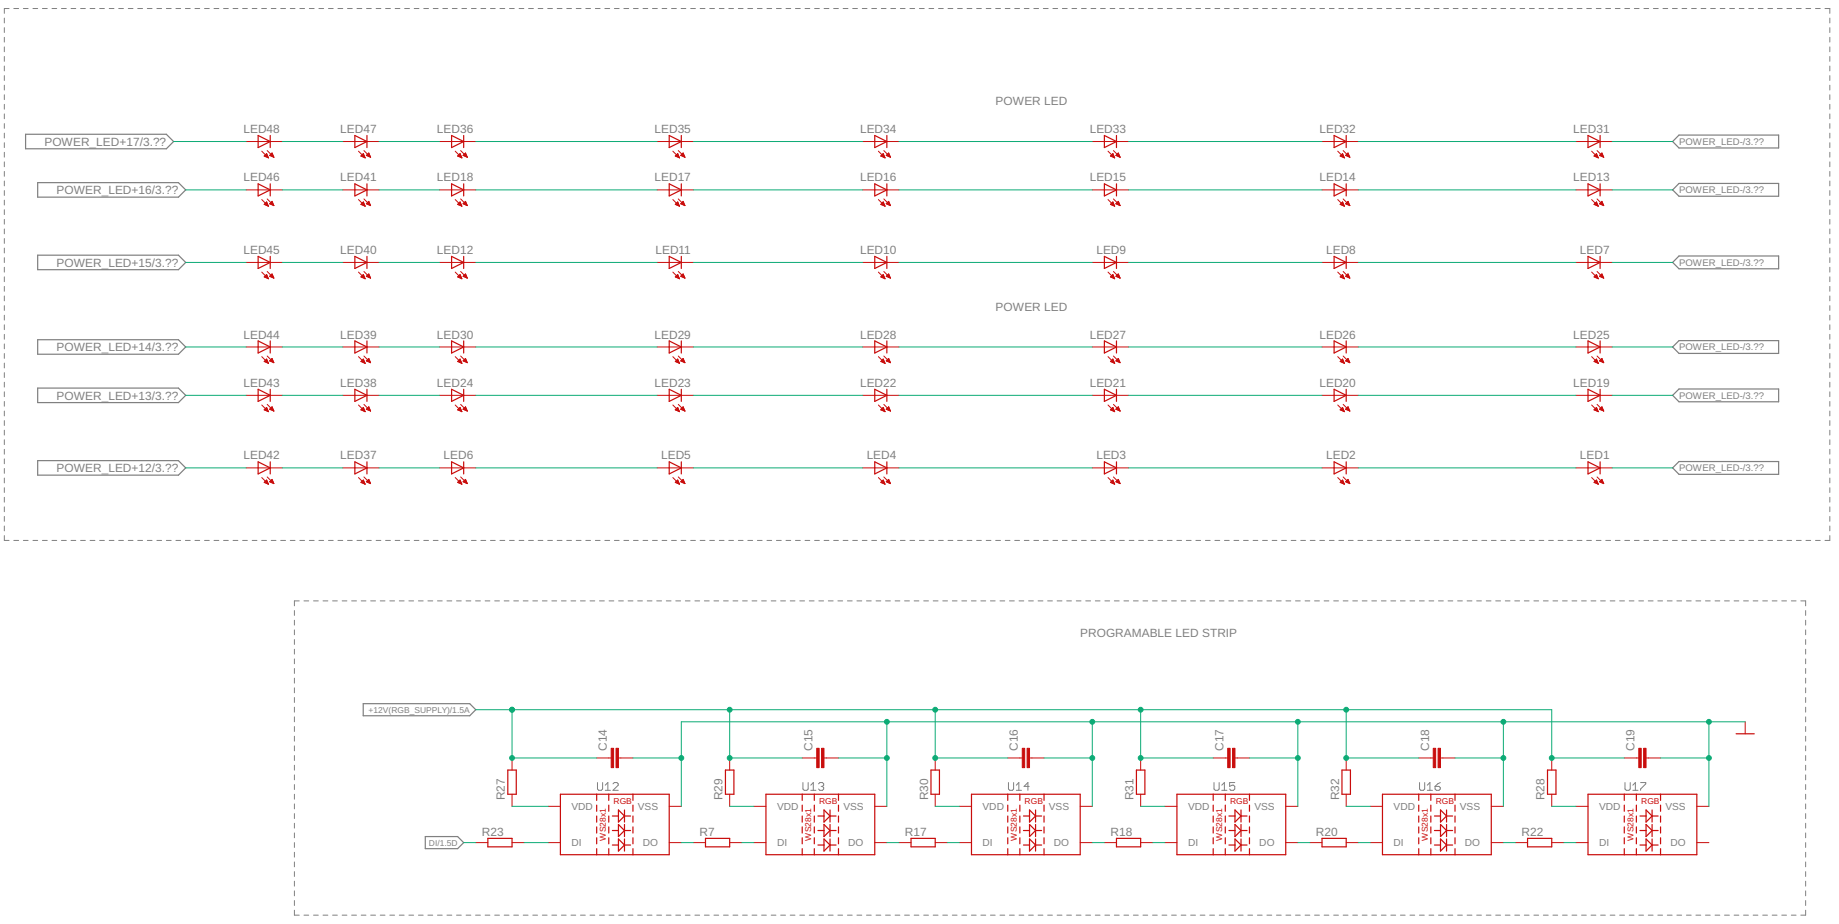
[picture p38: page 1]
