Mixior/Projekt_Przejsciowy/Materialy/eRower_Lights/PROJEKT/projekt_oswietlenia3.pdf

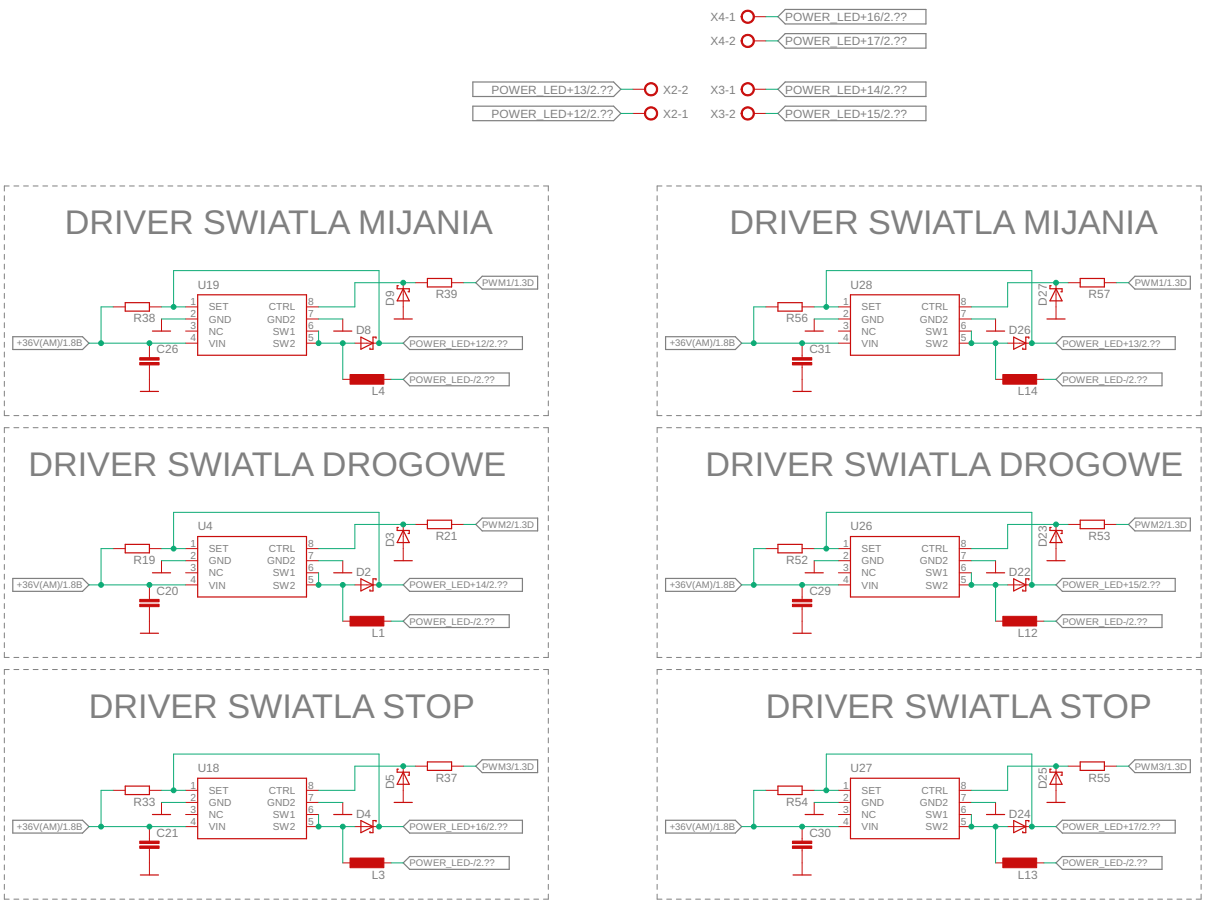
[picture p39: page 1]
