Mixior/Projekt_Przejsciowy/Materialy/Projekt oświetlenia w pojeździe - Nawrot, Smyczyński/Eagle/projekt_oswietlenia.brd

## EAGLE design Materialy/Projekt oświetlenia w pojeździe - Nawrot, Smyczyński/Eagle/projekt_oswietlenia.brd (2019-04-17)

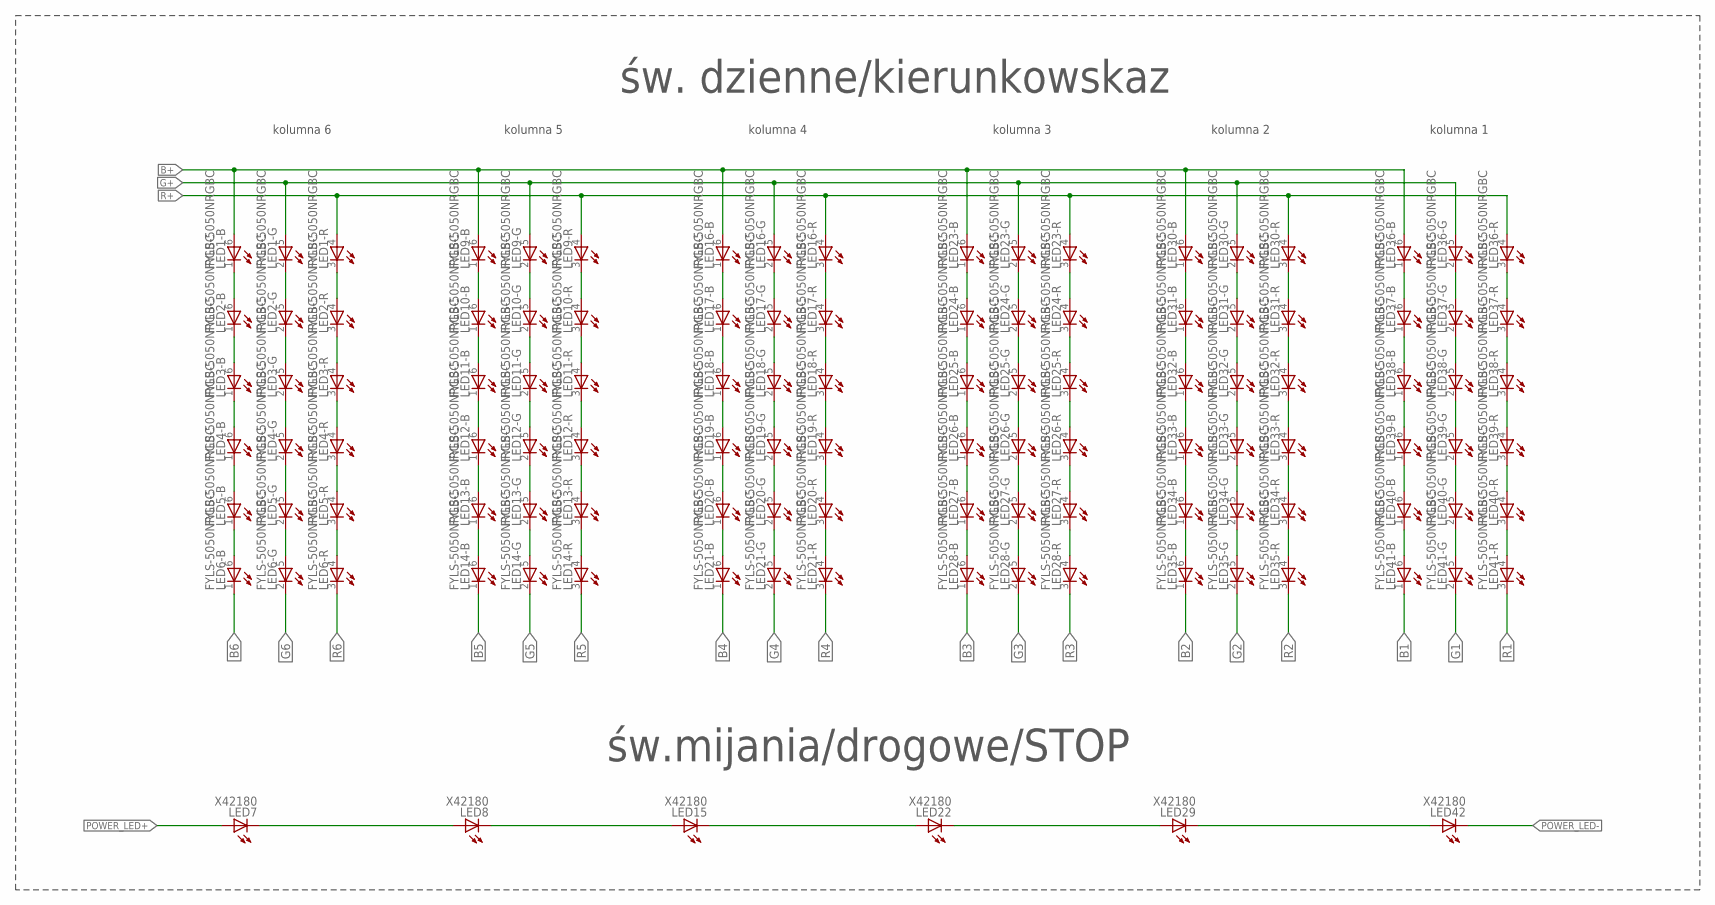
[picture p40: schematic projekt_oswietlenia.sch, sheet 1]

Parts:
LED1, LED2, LED3, LED4, LED5, LED6, LED9, LED10, LED11, LED12, LED13, LED14, LED16, LED17, LED18, LED19, LED20, LED21, LED23, LED24, LED25, LED26, LED27, LED28, LED30, LED31, LED32, LED33, LED34, LED35, LED36, LED37, LED38, LED39, LED40, LED41: FYLS-5050NRGBC; OVSTRGBBCR8
LED7, LED8, LED15, LED22, LED29, LED42: X42180; Z-POWER-LED-DOME-TYPE

Connections:
B1: LED41.1 (C); also elsewhere on the board
B2: LED35.1 (C); also elsewhere on the board
B3: LED28.1 (C); also elsewhere on the board
B4: LED21.1 (C); also elsewhere on the board
B5: LED14.1 (C); also elsewhere on the board
B6: LED6.1 (C); also elsewhere on the board
B+: LED1.6 (A), LED9.6 (A), LED16.6 (A), LED23.6 (A), LED30.6 (A), LED36.6 (A); also elsewhere on the board
G1: LED41.2 (C); also elsewhere on the board
G2: LED35.2 (C); also elsewhere on the board
G3: LED28.2 (C); also elsewhere on the board
G4: LED21.2 (C); also elsewhere on the board
G5: LED14.2 (C); also elsewhere on the board
G6: LED6.2 (C); also elsewhere on the board
G+: LED1.5 (A), LED9.5 (A), LED16.5 (A), LED23.5 (A), LED30.5 (A), LED36.5 (A); also elsewhere on the board
unnamed: LED13.3 (C), LED14.4 (A)
unnamed: LED13.2 (C), LED14.5 (A)
unnamed: LED13.1 (C), LED14.6 (A)
unnamed: LED12.3 (C), LED13.4 (A)
unnamed: LED12.2 (C), LED13.5 (A)
unnamed: LED12.1 (C), LED13.6 (A)
unnamed: LED11.1 (C), LED12.6 (A)
unnamed: LED11.2 (C), LED12.5 (A)
unnamed: LED11.3 (C), LED12.4 (A)
unnamed: LED10.3 (C), LED11.4 (A)
unnamed: LED10.2 (C), LED11.5 (A)
unnamed: LED29.C, LED42.A
unnamed: LED10.1 (C), LED11.6 (A)
unnamed: LED9.3 (C), LED10.4 (A)
unnamed: LED9.2 (C), LED10.5 (A)
unnamed: LED9.1 (C), LED10.6 (A)
unnamed: LED5.3 (C), LED6.4 (A)
unnamed: LED5.2 (C), LED6.5 (A)
unnamed: LED5.1 (C), LED6.6 (A)
unnamed: LED4.3 (C), LED5.4 (A)
unnamed: LED4.2 (C), LED5.5 (A)
unnamed: LED4.1 (C), LED5.6 (A)
unnamed: LED3.1 (C), LED4.6 (A)
unnamed: LED3.2 (C), LED4.5 (A)
unnamed: LED3.3 (C), LED4.4 (A)
unnamed: LED2.3 (C), LED3.4 (A)
unnamed: LED2.2 (C), LED3.5 (A)
unnamed: LED2.1 (C), LED3.6 (A)
unnamed: LED1.3 (C), LED2.4 (A)
unnamed: LED1.2 (C), LED2.5 (A)
unnamed: LED1.1 (C), LED2.6 (A)
unnamed: LED27.3 (C), LED28.4 (A)
unnamed: LED27.2 (C), LED28.5 (A)
unnamed: LED27.1 (C), LED28.6 (A)
unnamed: LED26.3 (C), LED27.4 (A)
unnamed: LED26.2 (C), LED27.5 (A)
unnamed: LED26.1 (C), LED27.6 (A)
unnamed: LED25.1 (C), LED26.6 (A)
unnamed: LED25.2 (C), LED26.5 (A)
unnamed: LED25.3 (C), LED26.4 (A)
unnamed: LED24.3 (C), LED25.4 (A)
unnamed: LED24.2 (C), LED25.5 (A)
unnamed: LED24.1 (C), LED25.6 (A)
unnamed: LED23.3 (C), LED24.4 (A)
unnamed: LED23.2 (C), LED24.5 (A)
unnamed: LED23.1 (C), LED24.6 (A)
unnamed: LED20.3 (C), LED21.4 (A)
unnamed: LED20.2 (C), LED21.5 (A)
unnamed: LED20.1 (C), LED21.6 (A)
unnamed: LED19.3 (C), LED20.4 (A)
unnamed: LED19.2 (C), LED20.5 (A)
unnamed: LED19.1 (C), LED20.6 (A)
unnamed: LED18.1 (C), LED19.6 (A)
unnamed: LED18.2 (C), LED19.5 (A)
unnamed: LED18.3 (C), LED19.4 (A)
unnamed: LED17.3 (C), LED18.4 (A)
unnamed: LED17.2 (C), LED18.5 (A)
unnamed: LED17.1 (C), LED18.6 (A)
unnamed: LED16.3 (C), LED17.4 (A)
unnamed: LED16.2 (C), LED17.5 (A)
unnamed: LED16.1 (C), LED17.6 (A)
unnamed: LED40.3 (C), LED41.4 (A)
unnamed: LED40.2 (C), LED41.5 (A)
unnamed: LED40.1 (C), LED41.6 (A)
unnamed: LED39.3 (C), LED40.4 (A)
unnamed: LED39.2 (C), LED40.5 (A)
unnamed: LED39.1 (C), LED40.6 (A)
unnamed: LED38.1 (C), LED39.6 (A)
unnamed: LED38.2 (C), LED39.5 (A)
unnamed: LED38.3 (C), LED39.4 (A)
unnamed: LED37.3 (C), LED38.4 (A)
unnamed: LED37.2 (C), LED38.5 (A)
unnamed: LED37.1 (C), LED38.6 (A)
unnamed: LED36.3 (C), LED37.4 (A)
unnamed: LED36.2 (C), LED37.5 (A)
unnamed: LED36.1 (C), LED37.6 (A)
unnamed: LED34.3 (C), LED35.4 (A)
unnamed: LED34.2 (C), LED35.5 (A)
unnamed: LED34.1 (C), LED35.6 (A)
unnamed: LED33.3 (C), LED34.4 (A)
unnamed: LED33.2 (C), LED34.5 (A)
unnamed: LED33.1 (C), LED34.6 (A)
unnamed: LED32.1 (C), LED33.6 (A)
unnamed: LED32.2 (C), LED33.5 (A)
unnamed: LED32.3 (C), LED33.4 (A)
unnamed: LED31.3 (C), LED32.4 (A)
unnamed: LED31.2 (C), LED32.5 (A)
unnamed: LED31.1 (C), LED32.6 (A)
unnamed: LED30.3 (C), LED31.4 (A)
unnamed: LED30.2 (C), LED31.5 (A)
unnamed: LED30.1 (C), LED31.6 (A)
unnamed: LED22.C, LED29.A
unnamed: LED15.C, LED22.A
unnamed: LED8.C, LED15.A
unnamed: LED7.C, LED8.A
POWER_LED+: LED7.A; also elsewhere on the board
POWER_LED-: LED42.C; also elsewhere on the board
R1: LED41.3 (C); also elsewhere on the board
R2: LED35.3 (C); also elsewhere on the board
R3: LED28.3 (C); also elsewhere on the board
R4: LED21.3 (C); also elsewhere on the board
R5: LED14.3 (C); also elsewhere on the board
R6: LED6.3 (C); also elsewhere on the board
R+: LED1.4 (A), LED9.4 (A), LED16.4 (A), LED23.4 (A), LED30.4 (A), LED36.4 (A); also elsewhere on the board

Notes on the sheet:
św. dzienne/kierunkowskaz
kolumna 6
kolumna 5
kolumna 4
kolumna 3
kolumna 2
kolumna 1
św.mijania/drogowe/STOP

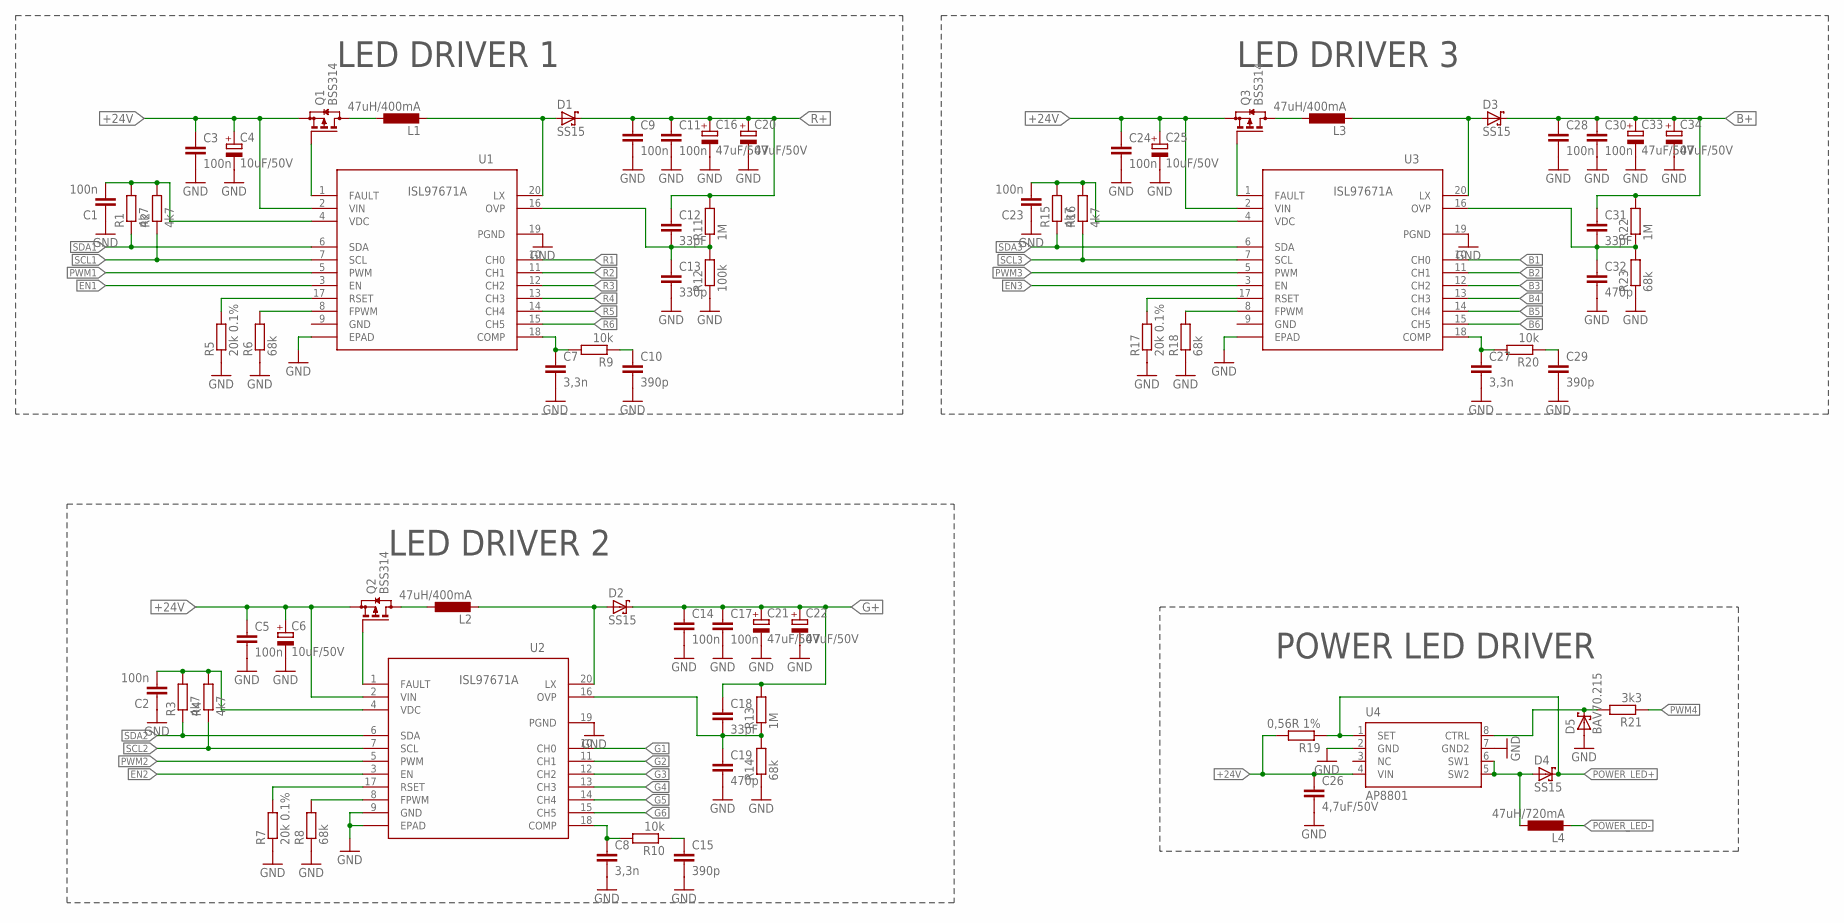
[picture p41: schematic projekt_oswietlenia.sch, sheet 2]

Parts:
C1, C2, C3, C5, C9, C11, C14, C17, C23, C24, C28, C30: 100n; C0603
C4, C6, C25: 10uF/50V; 153CLV-0605
C7, C8, C27: 3,3n; C0603
C10, C15, C29: 390p; C0603
C12, C18, C31: 33pF; C0603
C13: 330p; C0603
C16, C20, C21, C22, C33, C34: 47uF/50V; 153CLV-0605
C19, C32: 470p; C0603
C26: 4,7uF/50V; C0603
D1, D2, D3, D4: SS15; DO-214AC
D5: BAV70.215; SOT23
L1, L2, L3: 47uH/400mA; POWER-CHOKE_WE-TPC
L4: 47uH/720mA; POWER-CHOKE_WE-TPC
Q1, Q2, Q3: BSS314; SOT23
R1, R2, R3, R4, R15, R16: 4k7; R0603
R5, R7, R17: 20k 0.1%; R0603
R6, R8, R14, R18, R23: 68k; R0603
R9, R10, R20: 10k; R0603
R11, R13, R22: 1M; R0603
R12: 100k; R0603
R19: 0,56R 1%; R0603
R21: 3k3; R0603
U1, U2, U3: ISL97671A; QFN20
U4: AP8801; SOP-08

Connections:
+24V: C3.1, C4.+, C5.1, C6.+, C24.1, C25.+, C26.1, Q1.2 (S), Q2.2 (S), Q3.2 (S), R19.2, U1.2 (VIN), U2.2 (VIN), U3.2 (VIN), U4.4 (VIN); also elsewhere on the board
B1: U3.10 (CH0); also elsewhere on the board
B2: U3.11 (CH1); also elsewhere on the board
B3: U3.12 (CH2); also elsewhere on the board
B4: U3.13 (CH3); also elsewhere on the board
B5: U3.14 (CH4); also elsewhere on the board
B6: U3.15 (CH5); also elsewhere on the board
B+: C28.1, C30.1, C31.1, C33.+, C34.+, D3.C, R22.2; also elsewhere on the board
EN1: U1.3 (EN); also elsewhere on the board
EN2: U2.3 (EN); also elsewhere on the board
EN3: U3.3 (EN); also elsewhere on the board
G1: U2.10 (CH0); also elsewhere on the board
G2: U2.11 (CH1); also elsewhere on the board
G3: U2.12 (CH2); also elsewhere on the board
G4: U2.13 (CH3); also elsewhere on the board
G5: U2.14 (CH4); also elsewhere on the board
G6: U2.15 (CH5); also elsewhere on the board
G+: C14.1, C17.1, C18.1, C21.+, C22.+, D2.C, R13.2; also elsewhere on the board
GND: C1.1, C2.1, C3.2, C4.-, C5.2, C6.-, C7.2, C8.2, C9.2, C10.2, C11.2, C13.2, C14.2, C15.2, C16.-, C17.2, C19.2, C20.-, C21.-, C22.-, C23.1, C24.2, C25.-, C26.2, C27.2, C28.2, C29.2, C30.2, C32.2, C33.-, C34.-, D5.1 (A), R5.1, R6.1, R7.1, R8.1, R12.1, R14.1, R17.1, R18.1, R23.1, U1.9 (GND), U1.19 (PGND), U1.EPAD, U2.9 (GND), U2.19 (PGND), U2.EPAD, U3.9 (GND), U3.19 (PGND), U3.EPAD, U4.2 (GND), U4.7 (GND2); also elsewhere on the board
unnamed: D4.A, L4.1, U4.5 (SW2), U4.6 (SW1)
unnamed: D5.3 (C), R21.2, U4.8 (CTRL)
unnamed: Q3.1 (G), U3.1 (FAULT)
unnamed: L3.1, Q3.3 (D)
unnamed: D3.A, L3.2, U3.20 (LX)
unnamed: C31.2, C32.1, R22.1, R23.2, U3.16 (OVP)
unnamed: C27.1, R20.2, U3.18 (COMP)
unnamed: C29.1, R20.1
unnamed: R18.2, U3.8 (FPWM)
unnamed: R17.2, U3.17 (RSET)
unnamed: Q1.1 (G), U1.1 (FAULT)
unnamed: L1.1, Q1.3 (D)
unnamed: D1.A, L1.2, U1.20 (LX)
unnamed: C12.2, C13.1, R11.1, R12.2, U1.16 (OVP)
unnamed: C7.1, R9.2, U1.18 (COMP)
unnamed: C10.1, R9.1
unnamed: R6.2, U1.8 (FPWM)
unnamed: C23.2, R15.2, R16.2, U3.4 (VDC)
unnamed: R5.2, U1.17 (RSET)
unnamed: C1.2, R1.2, R2.2, U1.4 (VDC)
unnamed: Q2.1 (G), U2.1 (FAULT)
unnamed: L2.1, Q2.3 (D)
unnamed: D2.A, L2.2, U2.20 (LX)
unnamed: C18.2, C19.1, R13.1, R14.2, U2.16 (OVP)
unnamed: C8.1, R10.2, U2.18 (COMP)
unnamed: C15.1, R10.1
unnamed: R8.2, U2.8 (FPWM)
unnamed: R7.2, U2.17 (RSET)
unnamed: C2.2, R3.2, R4.2, U2.4 (VDC)
POWER_LED+: D4.C, R19.1, U4.1 (SET); also elsewhere on the board
POWER_LED-: L4.2; also elsewhere on the board
PWM1: U1.5 (PWM); also elsewhere on the board
PWM2: U2.5 (PWM); also elsewhere on the board
PWM3: U3.5 (PWM); also elsewhere on the board
PWM4: R21.1; also elsewhere on the board
R1: U1.10 (CH0); also elsewhere on the board
R2: U1.11 (CH1); also elsewhere on the board
R3: U1.12 (CH2); also elsewhere on the board
R4: U1.13 (CH3); also elsewhere on the board
R5: U1.14 (CH4); also elsewhere on the board
R6: U1.15 (CH5); also elsewhere on the board
R+: C9.1, C11.1, C12.1, C16.+, C20.+, D1.C, R11.2; also elsewhere on the board
SCL1: R2.1, U1.7 (SCL); also elsewhere on the board
SCL2: R4.1, U2.7 (SCL); also elsewhere on the board
SCL3: R16.1, U3.7 (SCL); also elsewhere on the board
SDA1: R1.1, U1.6 (SDA); also elsewhere on the board
SDA2: R3.1, U2.6 (SDA); also elsewhere on the board
SDA3: R15.1, U3.6 (SDA); also elsewhere on the board

Notes on the sheet:
LED DRIVER 2
LED DRIVER 3
POWER LED DRIVER
LED DRIVER 1

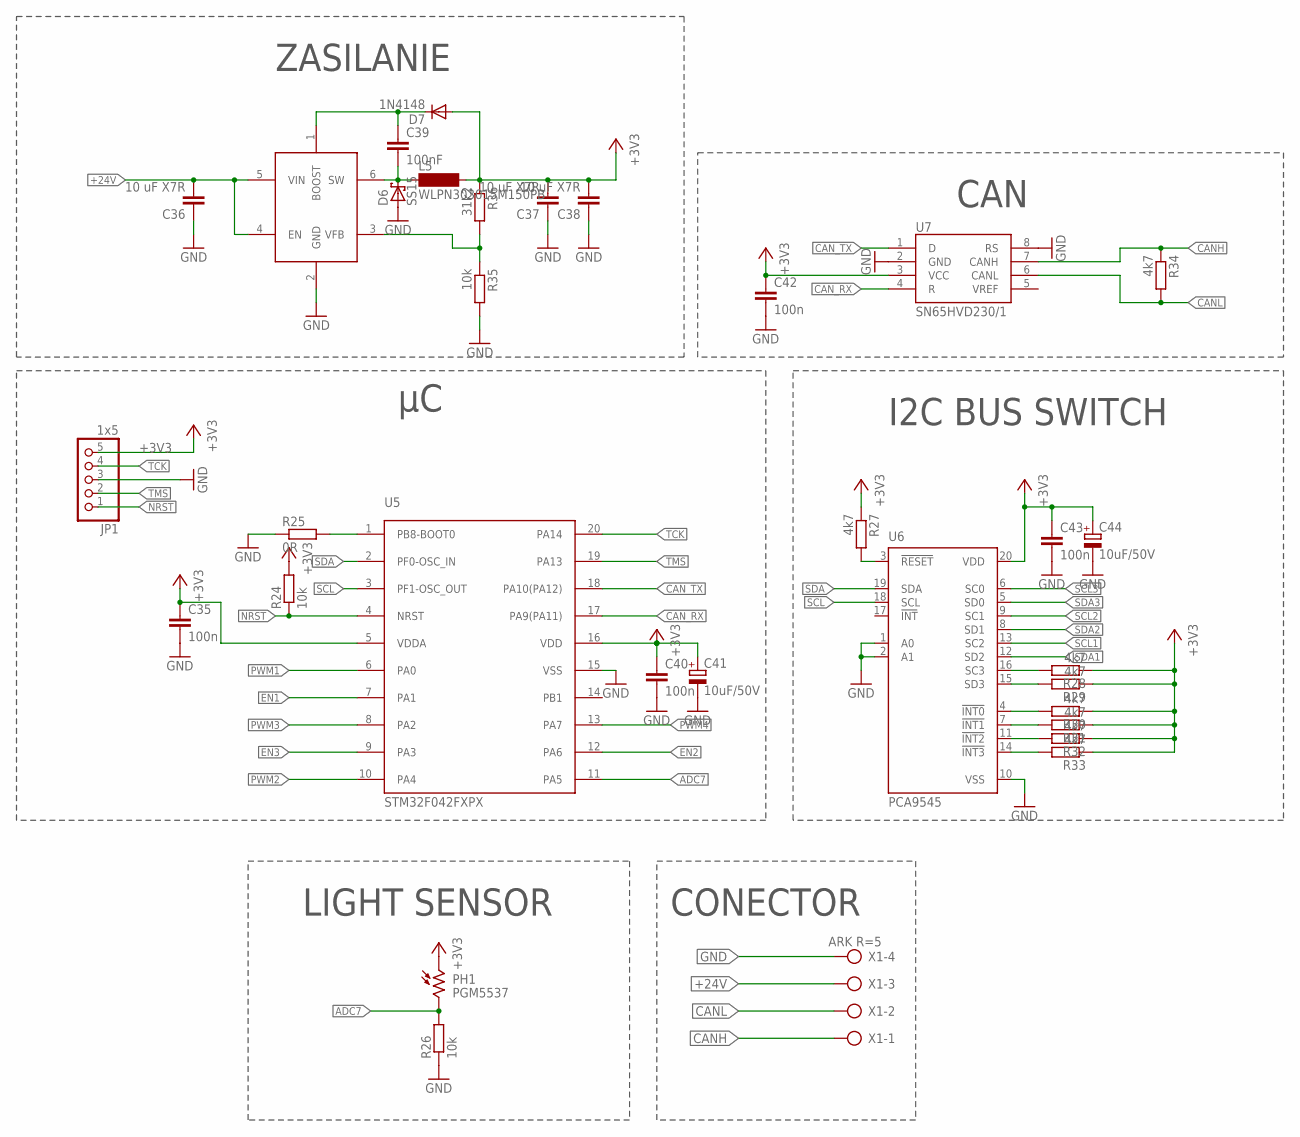
[picture p42: schematic projekt_oswietlenia.sch, sheet 3]

Parts:
C35, C40, C42, C43: 100n; C0603
C36, C37, C38: 10 uF X7R; C0603
C39: 100nF; C0603
C41, C44: 10uF/50V; 153CLV-0605
D6: SS15; DO-214AC
D7: 1N4148; SMB
IC1: MCP16301/H; SOT23-6
JP1: 1x5; 1X05
L5: WLPN303015M150PB; MS50
PH1: PGM5537; VT800
R24, R26, R35: 10k; R0603
R25: 0R; R0603
R27, R28, R29, R30, R31, R32, R33, R34: 4k7; R0603
R36: 31k2; R0603
U5: STM32F042FXPX; TSSOP20
U6: PCA9545; SO20W
U7: SN65HVD230/1; SO8
X1: ARK R=5; AK500/4

Connections:
+3V3: C35.1, C37.2, C38.2, C40.1, C41.+, C42.1, C43.1, C44.+, D7.A, JP1.5, L5.2, PH1.1, R24.2, R27.1, R28.1, R29.1, R30.1, R31.1, R32.1, R33.1, R36.1, U5.5 (VDDA), U5.16 (VDD), U6.20 (VDD), U7.3 (VCC)
+24V: C36.2, IC1.4 (EN), IC1.5 (VIN), X1.3; also elsewhere on the board
ADC7: PH1.2, R26.2, U5.11 (PA5)
CANH: R34.1, U7.7 (CANH), X1.1
CANL: R34.2, U7.6 (CANL), X1.2
CAN_RX: U5.17 (PA9(PA11)), U7.4 (R)
CAN_TX: U5.18 (PA10(PA12)), U7.1 (D)
EN1: U5.7 (PA1); also elsewhere on the board
EN2: U5.12 (PA6); also elsewhere on the board
EN3: U5.9 (PA3); also elsewhere on the board
GND: C35.2, C36.1, C37.1, C38.1, C40.2, C41.-, C42.2, C43.2, C44.-, D6.A, IC1.2 (GND), JP1.3, R25.1, R26.1, R35.2, U5.15 (VSS), U6.1 (A0), U6.2 (A1), U6.10 (VSS), U7.2 (GND), U7.8 (RS), X1.4; also elsewhere on the board
unnamed: C39.1, D7.C, IC1.1 (BOOST)
unnamed: R33.2, U6.14 (!INT3)
unnamed: R32.2, U6.11 (!INT2)
unnamed: R31.2, U6.7 (!INT1)
unnamed: R30.2, U6.4 (!INT0)
unnamed: R29.2, U6.15 (SD3)
unnamed: R28.2, U6.16 (SC3)
unnamed: R27.2, U6.3 (!RESET)
unnamed: C39.2, D6.C, IC1.6 (SW), L5.1
unnamed: IC1.3 (VFB), R35.1, R36.2
unnamed: R25.2, U5.1 (PB8-BOOT0)
NRST: JP1.1, R24.1, U5.4 (NRST)
PWM1: U5.6 (PA0); also elsewhere on the board
PWM2: U5.10 (PA4); also elsewhere on the board
PWM3: U5.8 (PA2); also elsewhere on the board
PWM4: U5.13 (PA7); also elsewhere on the board
SCL: U5.3 (PF1-OSC_OUT), U6.18 (SCL)
SCL1: U6.13 (SC2); also elsewhere on the board
SCL2: U6.9 (SC1); also elsewhere on the board
SCL3: U6.6 (SC0); also elsewhere on the board
SDA: U5.2 (PF0-OSC_IN), U6.19 (SDA)
SDA1: U6.12 (SD2); also elsewhere on the board
SDA2: U6.8 (SD1); also elsewhere on the board
SDA3: U6.5 (SD0); also elsewhere on the board
TCK: JP1.4, U5.20 (PA14)
TMS: JP1.2, U5.19 (PA13)

Notes on the sheet:
CAN
LIGHT SENSOR
CONECTOR
ZASILANIE
I2C BUS SWITCH

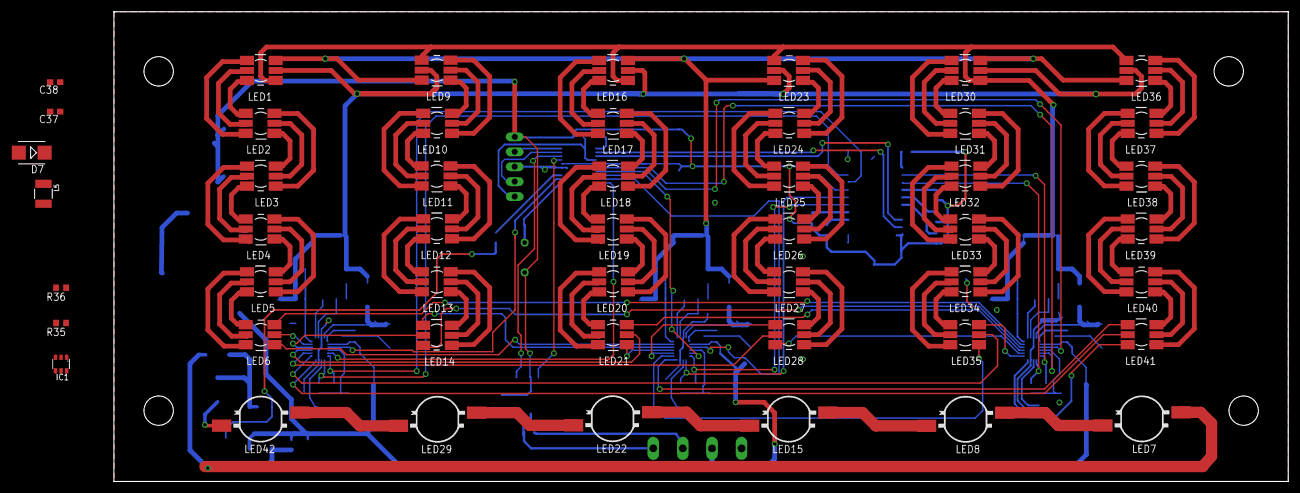
[picture p43: board projekt_oswietlenia.brd from above]

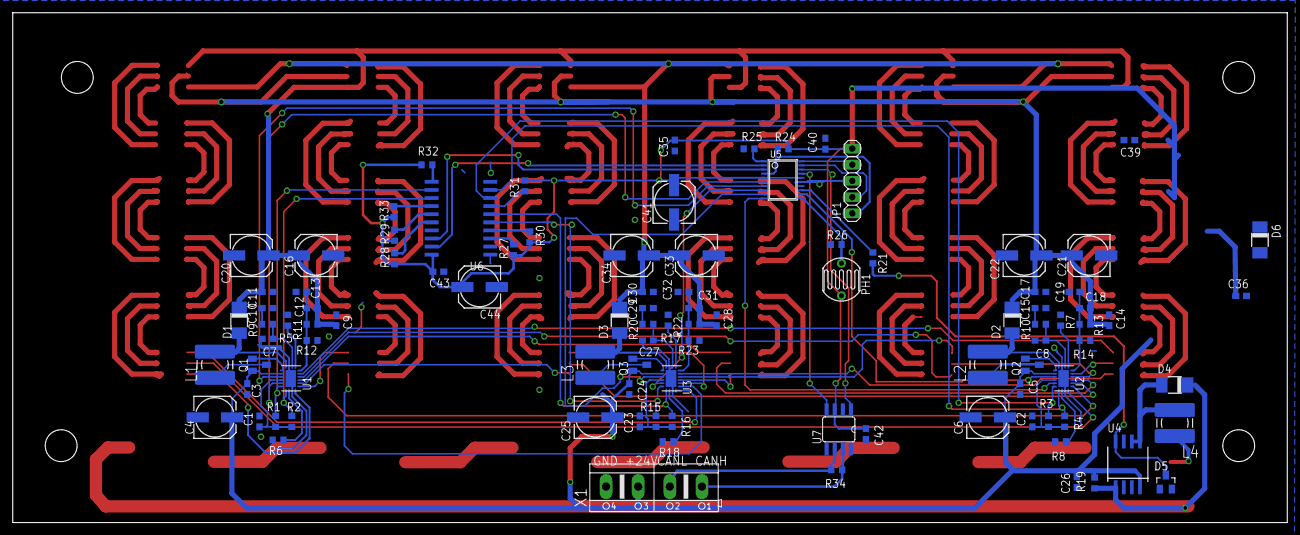
[picture p44: board projekt_oswietlenia.brd from below]

Board: 2 copper layers, 200.0 x 80.0 mm, 148 parts (99 on the bottom side), 184 nets.
